farezhalim/vehicle-immobilizing-device/testing/software/Testing_Development/IMG_20190217_155356.jpg

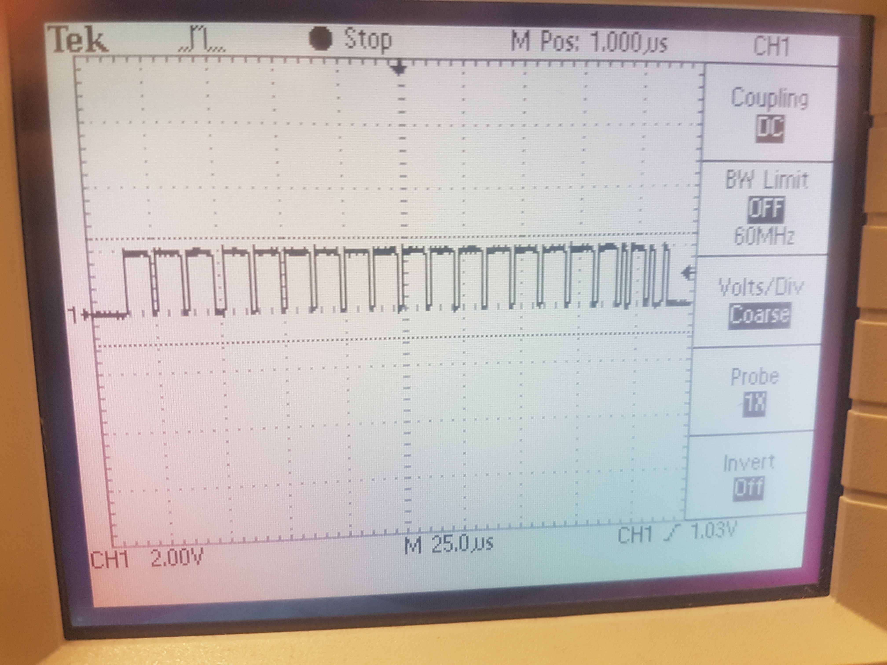
testing/software/Testing_Development/IMG_20190217_155356.jpg
