farezhalim/vehicle-immobilizing-device/hardware/mechanical/dongle_form-factor.png

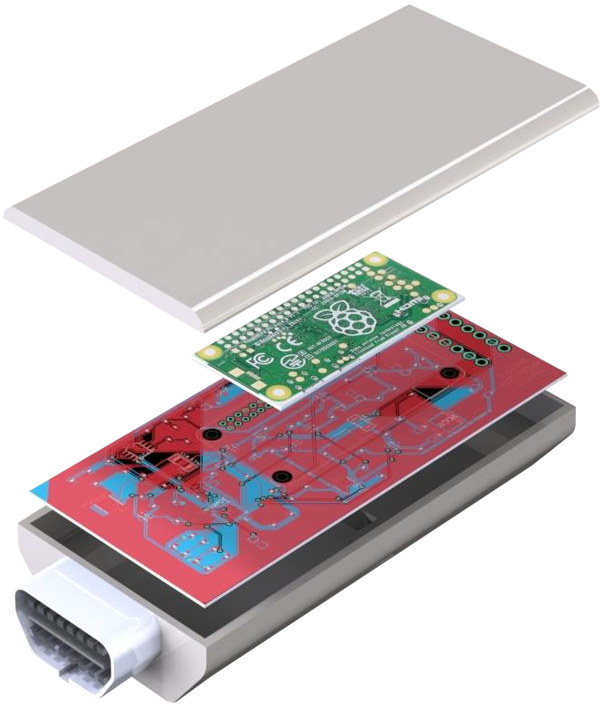
hardware/mechanical/dongle_form-factor.png
