farezhalim/vehicle-immobilizing-device/README.md

# Vehicle Immobilizing Device
*ECE Capstone 2018-2019 Group 7*

The vehicle immobilization device monitors a vehicle's speed and acceleration through a combination of OBD-II queries and a digital accelerometer, and upon detection of a collision, the device immobilizes the vehicle by injecting CAN packets to ECUs in the vehicle. To disable the immobilization, an override is sent through Bluetooth using an Android app to the device to halt CAN message injection.

There are four main sections:
1. App (For Smartphone app for authority, disabling action)
2. Hardware (All Electrical hardware schematics, pcb's, etc. Include Mechanical Design as well, solidworks files, and concept designs.)
2. Software (Resides on main processcor, Raspberry Pi Zero W)
2. Testing  (Verification using ECU Simulator)

For more info, please view the presentation slides and report document.
