farezhalim/vehicle-immobilizing-device/hardware/readme.md

# Hardware design

The folders here contain hardware and conceptual designs pertaining to the project.
1. `future` contains the EAGLE schematic and board files for the design of the final product
2. `manufacturer` contains reference material used in the design (i.e. other OBD-II interpreter board)
3. `mechanical` contains the Solidworks files associated with product casing 
4. `prototype-491` contains EAGLE schematic and board files for the proof-of-concept built during ECE 491 Capstone
5. `lbr` contains all the necessary EAGLE libraries
