farezhalim/vehicle-immobilizing-device/hardware/mechanical/locking.jpg

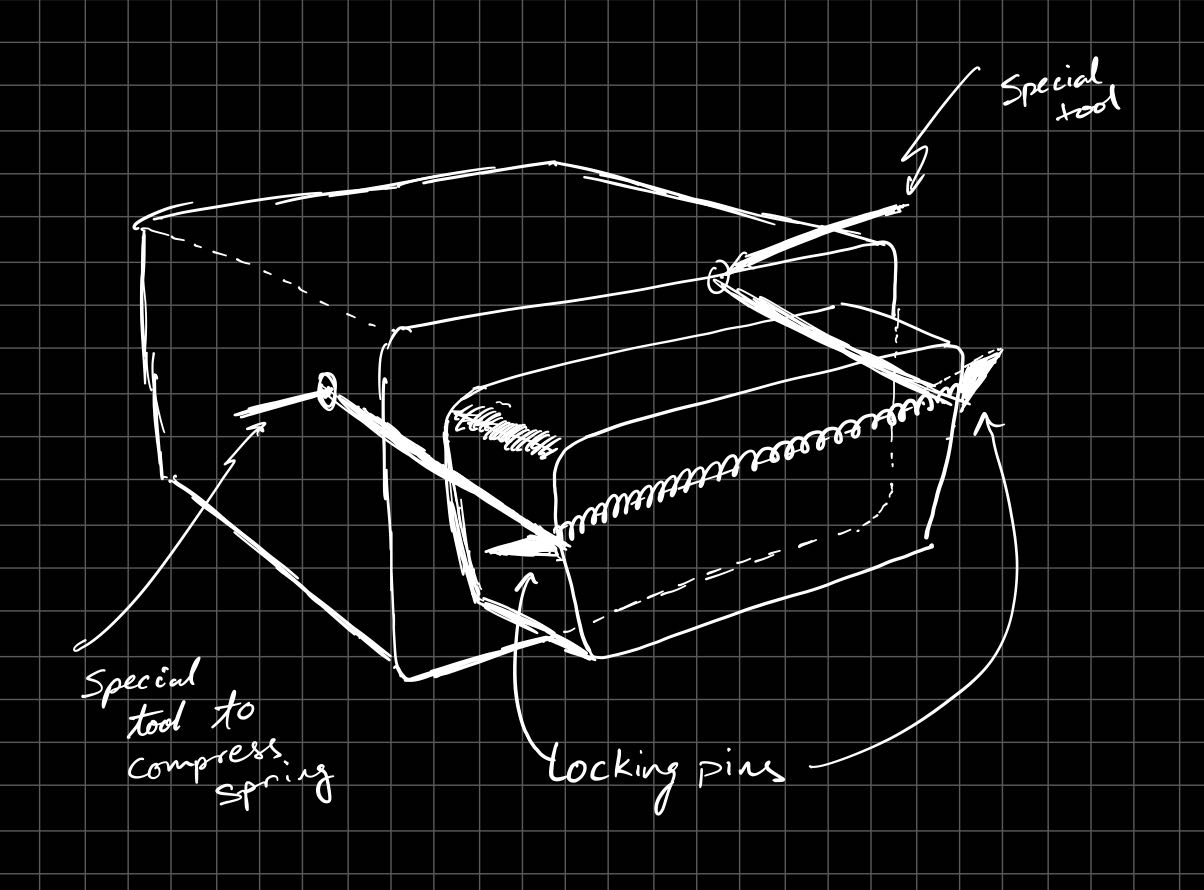
hardware/mechanical/locking.jpg
