farezhalim/vehicle-immobilizing-device/hardware/future/partslist.xlsx

Complete bill of materials
 | Value | Description |  | Qty. | Unit $ | Total $
Capacitors |  |  |  |  |  | $0.39
 | 1uF | Capacitor |  | 5 | $0.0058 | $0.03
 | 2.2uF | Capacitor |  | 1 | $0.0200 | $0.02
 | 27pF | Capacitor |  | 2 | $0.0090 | $0.02
 | 4.7uF | Capacitor |  | 1 | $0.0320 | $0.03
 | 470pF | Capacitor |  | 1 | $0.0127 | $0.01
 | 560pF | Capacitor |  | 2 | $0.0065 | $0.01
 | 10uF | Capacitor |  | 4 | $0.0490 | $0.20
 | 0.1uF | Capacitor |  | 5 | $0.0049 | $0.02
 | 10uF | Capacitor |  | 1 | $0.0490 | $0.05
Diodes |  |  |  |  |  | $1.29
 | BAS16 | Diode |  | 3 | $0.20 | $0.60
 | MBRA140 | Diode |  | 1 | $0.69 | $0.69
STN1110 - OBD II to UART Interpreter, PDIP Package |  |  |  |  |  | $7.65
 | SCANTOOL | STN1110 - OBD II to UART Interpreter, QFN-28-S |  | 1 | $7.65 | $7.65
Quad Differential Comparators |  |  |  |  |  | $1.16
 | LM339PWR | Quad Differential Comparators |  | 2 | $0.58 | $1.16
CAN Driver |  |  |  |  |  | $1.86
 | MCP2551 | CAN Driver |  | 1 | $1.86 | $1.86
Header |  |  |  |  | $2.00
 | DNP | Header |  | 1
 |  | Header |  | 1
LEDs |  |  |  |  |  | $4.38
 | RED | LED |  | 3 | $0.32 | $0.96
 | YELLOW | LED |  | 2 | $0.39 | $0.78
 | GREEN | LED |  | 3 | $0.88 | $2.64
Transistors NPN |  |  |  |  |  | $0.66
 | MMBT2222 | Transistor NPN |  | 3 | $0.22 | $0.66
Resistors |  |  |  |  |  | $2.68
 | 100 | Resistor |  | 2 | $0.033 | $0.07
 | 240 | Resistor |  | 1 | $0.033 | $0.03
 | 330 | Resistor |  | 4 | $0.072 | $0.29
 | 374 | Resistor |  | 1 | $0.007 | $0.01
 | 866 | Resistor |  | 1 | $0.072 | $0.07
 | 1.2k | Resistor |  | 1 | $0.072 | $0.07
 | 1.5k | Resistor |  | 2 | $0.072 | $0.14
 | 10k | Resistor |  | 20 | $0.033 | $0.66
 | 1k | Resistor |  | 4 | $0.034 | $0.13
 | 4.7k | Resistor |  | 3 | $0.072 | $0.22
 | 62K | Resistor |  | 1 | $0.072 | $0.07
 | 510 0.5W | Resistor |  | 2 | $0.460 | $0.92
Voltage Regulators |  |  |  |  |  | $2.48
 |  | Voltage Regulator |  | 1 | $0.83 | $0.83
 | 3.3V | Voltage Regulator |  | 1 | $0.73 | $0.73
 | 5V Reg. | Voltage Regulator |  | 1 | $0.92 | $0.92
ADXL345 - Digital 3-Axis Accelerometer (I2C/SPI) |  |  |  |  |  | $12.32
 |  | ADXL345 - Digital 3-Axis Accelerometer (I2C/SPI) |  | 1 | $12.32 | $12.32
OBD Connector |  |  |  |  |  | $1.11
 | Male OBD2 |  | https://elmwoodelectronics.ca/products/9911?variant=28164458371 | 1 | $7.99 | $7.99
Crystals |  |  |  |  |  | $1.32
 | 16MHz | Crystals |  | 1 | $1.32 | $1.32
MOSFET |  |  |  |  |  | $2.73
 | BSS138 | MOSFET |  | 4 | $0.45 | $1.80
 | ZXMP6A13FTA | MOSFET |  | 1 | $0.93 | $0.93
Raspberry Pi Zero |  |  |  |  |  | $35.03
 | RPI-ZERO | Raspberry Pi Zero W |  | 1 | $35.03 | $35.03
 |  |  |  |  | Grand total | $75.07
