farezhalim/vehicle-immobilizing-device/hardware/manufacturer/OBDII-UART/README.md

OBD-II UART
===========

<table class="table table-hover table-striped table-bordered">
  <tr align="center">
   <td><a href="https://cdn.sparkfun.com//assets/parts/3/3/1/4/09555-01a.jpg">OBD-II UART</a></td>
   <td><a href="https://cdn.sparkfun.com//assets/parts/5/7/1/5/10769-01.jpg">SparkFun Car Diagnostics Kit (RTL-10769)</a></td>
  </tr>
  <tr align="center">
    <td><a href="https://www.sparkfun.com/products/9555">OBD-II UART (WIG-09555)</a></td>
    <td><a href="https://www.sparkfun.com/products/10769">SparkFun Car Diagnostics Kit (RTL-10769)</a></td>
  </tr>
</table>

A board that provides a serial interface using the ELM327 command set with a vehicle's OBD-II bus, and supports all major OBD-II standards. 

Repository Contents
-------------------
* **/Firmware** - Example Arduino sketch
* **/Hardware** - All Eagle design files (.brd, .sch)
* **/Software** - Information about desktop program to use with this board. 

Documentation
--------------
* **[Hookup Guide](https://learn.sparkfun.com/tutorials/obd-ii-uart-hookup-guide)** - Basic hookup guide for the OBD-II UART.

Product Versions
----------------
* [WIG-09555](https://www.sparkfun.com/products/9555) - OBD-II UART board
* [RTL-10769](https://www.sparkfun.com/products/10769) - Car Diagnostics Kit Retail, with OBD-II UART and OBD to DB9 cable.

License Information
-------------------
The hardware is released under [Creative Commons Share-alike 3.0](http://creativecommons.org/licenses/by-sa/3.0/).  
All other code is open source so please feel free to do anything you want with it; you buy me a beer if you use this and we meet someday ([Beerware license](http://en.wikipedia.org/wiki/Beerware)).
