farezhalim/vehicle-immobilizing-device/hardware/manufacturer/Adafruit-ADXL345/Adafruit_ADXL345_PCB-master/readme.txt

This is the PCB for the Adafruit 5V ready ADXL345 Digital
Triple-Axis Acceleromter (I2C or SPI)

Format is EagleCAD schematic and board layout

For more details, check out the product page at

-----> https://www.adafruit.com/products/1231

Adafruit invests time and resources providing this open source design, 
please support Adafruit and open-source hardware by purchasing 
products from Adafruit!

Designed by Adafruit Industries.  
Creative Commons Attribution, Share-Alike license, check license.txt for more information
All text above must be included in any redistribution
