farezhalim/vehicle-immobilizing-device/testing/readme.md

# Testing the proof of concept

This electronic control unit (ECU) simulator  eliminates  the  need  to  procure  a  real vehicle, and mitigates risks associated with testing in the real world.

The Arduino was programmed to simulate an ECU by performing the following functions:
1. Respond to standard OBD-II parameter queries. In our case, the simulator returned a randomly generated vehicle speed
2. Indicate normal vehicle operation through a green LED
3. Perform an action (turn on a red LED) when receiving specific CAN packets to demonstrate vehicle immobilization

This code is located in `testing/software/Signal_Read_and_Write` in the .ino file.

After flashing this code on to any Arduino Uno, connect said Arduino to the CAN controller/transceiver circuitry described in `testing/hardware`. 
Connect the CAN HI/LO from the CAN Transceiver to the CAN HI/LO of the proof of concept device to establish communication between the two modules.
The Arduino was customized to accept certain packets (mimicking CAN packet injection) to cause a GPIO pin to go high, as a result powering on an LED to indicated immobilization.

In addition to vehicle speed, the Arduino can also be queried for other OBD-II parameters such as:
*  RPM
*  Coolant temperature
*  Intake air temperature (IAT)
*  Mass (air) flow (MAF)
*  Ambient air temperature

For more information about OBD-II parameters:

[http://en.wikipedia.org/wiki/OBD-II_PIDs](http://en.wikipedia.org/wiki/OBD-II_PIDs)
