farezhalim/vehicle-immobilizing-device/testing/software/Testing_Development/CAN Waveform Interpretation.pptx

0b11

Bit stuff 1

five 0’s and bit stuff 1 repeats

0

00000

101

0111

0000 with a bit stuff 1

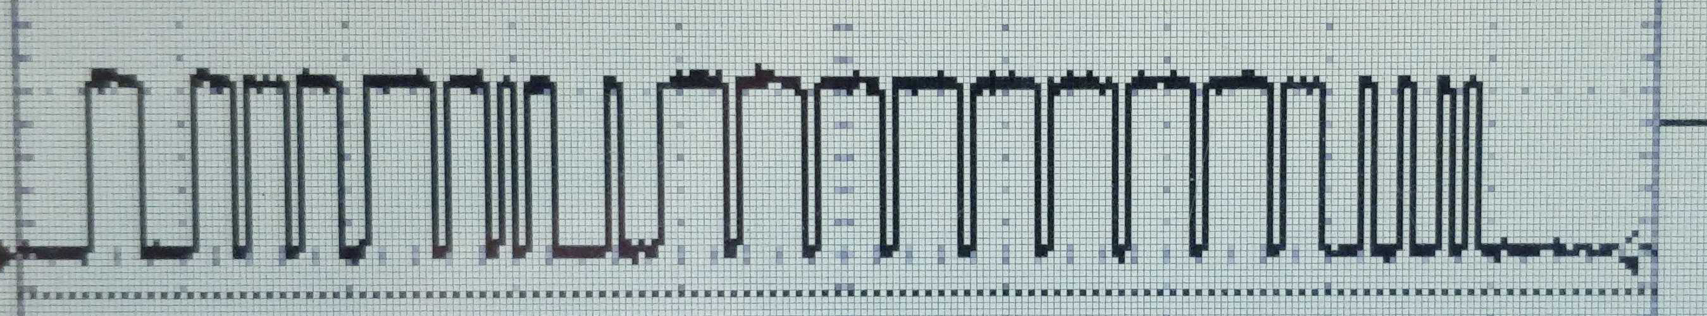
[picture p25: figure]

000

001111

0000 with a bit stuff 1

This is where the message seems to stop
