farezhalim/vehicle-immobilizing-device/testing/accelerometer/data/back_alley_drive.csv

t | x | y | z
0.04 | 1.69 | -0.04 | 8.75
0.07 | 1.65 | -0.04 | 8.63
0.11 | 1.49 | -0.04 | 8.67
0.14 | 1.61 | -0.12 | 9.02
0.18 | 1.77 | -0.08 | 8.98
0.21 | 1.65 | -0.12 | 9.18
0.25 | 1.8 | 0 | 8.63
0.29 | 1.65 | -0.04 | 8.39
0.32 | 1.49 | 0 | 8.63
0.36 | 1.65 | -0.04 | 8.87
0.39 | 1.69 | -0.04 | 8.51
0.43 | 1.69 | -0.04 | 9.34
0.46 | 1.77 | 0.04 | 9.26
0.50 | 1.65 | 0 | 8.79
0.54 | 1.53 | 0.08 | 8.94
0.57 | 1.61 | 0.04 | 8.55
0.61 | 1.61 | 0 | 8
0.64 | 1.77 | 0 | 8.98
0.68 | 1.88 | 0 | 8.9
0.71 | 1.8 | -0.04 | 8.79
0.75 | 1.8 | 0 | 9.3
0.79 | 1.88 | 0 | 8.83
0.82 | 1.57 | -0.04 | 8.47
0.86 | 1.73 | -0.08 | 8.63
0.89 | 1.84 | -0.24 | 8.47
0.93 | 1.73 | -0.16 | 9.02
0.96 | 1.8 | 0 | 8.83
1.00 | 1.65 | -0.24 | 8.83
1.04 | 1.61 | 0 | 9.02
1.07 | 1.73 | -0.08 | 9.45
1.11 | 1.49 | -0.31 | 8.39
1.14 | 1.65 | -0.47 | 8.63
1.18 | 2 | -0.31 | 8.67
1.21 | 1.92 | -0.27 | 8.32
1.25 | 1.73 | -0.16 | 9.18
1.29 | 1.88 | 0.04 | 8.98
1.32 | 1.69 | 0 | 8.59
1.36 | 1.61 | -0.08 | 8.75
1.39 | 1.92 | -0.12 | 8.67
1.43 | 1.8 | -0.2 | 8.55
1.46 | 1.77 | -0.16 | 8.87
1.50 | 1.69 | -0.04 | 8.71
1.54 | 1.53 | -0.04 | 8.67
1.57 | 1.61 | -0.04 | 8.67
1.61 | 1.8 | 0 | 8.39
1.64 | 1.8 | 0 | 8.79
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
