farezhalim/vehicle-immobilizing-device/testing/accelerometer/data/drive_2.csv

t | x | y | z
0.04 | 1.45 | -0.63 | 7.65
0.07 | 1.41 | -0.67 | 7.77
0.11 | 1.37 | -0.59 | 8.87
0.14 | 1.53 | -0.08 | 8.79
0.18 | 1.37 | -0.04 | 8.04
0.21 | 1.41 | -0.08 | 9.02
0.25 | 1.53 | -0.08 | 8.63
0.29 | 1.49 | -0.08 | 8.63
0.32 | 1.57 | 0 | 8.59
0.36 | 1.84 | 0.12 | 9.02
0.39 | 1.77 | 0.43 | 8.98
0.43 | 1.69 | 0.35 | 10.04
0.46 | 1.8 | 0.39 | 9.3
0.50 | 1.92 | 0.43 | 8.79
0.54 | 1.57 | 0.27 | 8.98
0.57 | 1.49 | 0.31 | 8.98
0.61 | 1.53 | 0.04 | 8.67
0.64 | 1.53 | 0.08 | 8.75
0.68 | 1.8 | 0.16 | 8.87
0.71 | 1.8 | 0.31 | 8.43
0.75 | 1.33 | 0.43 | 9.3
0.79 | 1.29 | 0.2 | 9.14
0.82 | 1.29 | 0.04 | 8.04
0.86 | 1.45 | 0.08 | 8.67
0.89 | 1.57 | 0.08 | 8.79
0.93 | 1.45 | 0 | 8.39
0.96 | 1.26 | 0.08 | 8.59
1.00 | 1.33 | 0.31 | 8.9
1.04 | 1.37 | 0.43 | 9.1
1.07 | 1.26 | 0.39 | 8.71
1.11 | 1.33 | 0.35 | 8.87
1.14 | 1.26 | 0.39 | 9.22
1.18 | 1.29 | 0.16 | 8.63
1.21 | 1.26 | 0.24 | 8.83
1.25 | 1.49 | 0.31 | 9.45
1.29 | 1.57 | 0.47 | 9.26
1.32 | 1.37 | 0.31 | 9.34
1.36 | 1.41 | 0.27 | 9.06
1.39 | 1.49 | 0.16 | 9.14
1.43 | 1.45 | 0.12 | 8.04
1.46 | 1.22 | 0 | 8
1.50 | 1.29 | 0.04 | 9.18
1.54 | 1.57 | -0.04 | 9.49
1.57 | 1.41 | -0.04 | 8.43
1.61 | 1.41 | 0 | 8.47
1.64 | 1.29 | 0.12 | 8.32
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
