farezhalim/vehicle-immobilizing-device/testing/accelerometer/data/drive_3.csv

t | x | y | z
0.04 | 1.49 | 0.12 | 8.24
0.07 | 1.49 | 0.35 | 8
0.11 | 1.18 | 0.39 | 8.67
0.14 | 1.14 | 0.16 | 9.14
0.18 | 1.37 | 0.24 | 9.41
0.21 | 1.57 | 0.27 | 9.14
0.25 | 1.57 | 0.63 | 8.94
0.29 | 1.49 | 0.75 | 8.94
0.32 | 1.49 | 0.63 | 8.87
0.36 | 1.49 | 0.35 | 9.02
0.39 | 1.61 | 0.2 | 8.94
0.43 | 1.61 | 0.24 | 9.1
0.46 | 1.53 | 0.2 | 8.9
0.50 | 1.53 | 0.08 | 8.39
0.54 | 1.49 | 0 | 8.24
0.57 | 1.37 | 0.04 | 8.32
0.61 | 1.33 | 0 | 8.94
0.64 | 1.49 | -0.08 | 9.14
0.68 | 1.49 | 0.12 | 8.32
0.71 | 1.45 | 0.31 | 8.63
0.75 | 1.37 | 0.47 | 8.83
0.79 | 1.1 | 0.75 | 9.45
0.82 | 1.45 | 0.31 | 9.65
0.86 | 1.53 | 0.67 | 9.02
0.89 | 1.49 | 0.82 | 8.67
0.93 | 1.37 | 0.98 | 9.3
0.96 | 1.06 | 0.82 | 8.98
1.00 | 1.26 | 0.24 | 9.22
1.04 | 1.06 | 0.43 | 8.43
1.07 | 0.82 | -0.27 | 8.43
1.11 | 0.43 | -0.24 | 8.51
1.14 | 0.47 | -0.35 | 8.43
1.18 | 0.47 | -0.24 | 8.36
1.21 | 0.43 | -0.12 | 8.2
1.25 | 0.59 | -0.04 | 8.12
1.29 | 0.43 | 0.04 | 8.75
1.32 | 0.51 | 0 | 8.67
1.36 | 0.51 | 0.12 | 8.28
1.39 | 0.47 | 0.12 | 8.2
1.43 | 0.35 | 0.08 | 8.71
1.46 | 0.35 | 0.2 | 9.1
1.50 | 0.51 | 0 | 9.34
1.54 | 0.51 | -0.12 | 9.45
1.57 | 0.63 | -0.04 | 8.36
1.61 | 0.47 | -0.31 | 8.94
1.64 | 0.12 | -0.24 | 10.24
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
