farezhalim/vehicle-immobilizing-device/testing/accelerometer/data/drive_4.csv

t | x | y | z
0.04 | 0.78 | -0.51 | 8.55
0.07 | 1.02 | -0.27 | 8.51
0.11 | 0.82 | -0.27 | 9.1
0.14 | 0.78 | -0.24 | 9.73
0.18 | 1.1 | -0.39 | 8.55
0.21 | 0.78 | -0.43 | 9.06
0.25 | 1.14 | -0.63 | 7.92
0.29 | 0.71 | -0.24 | 8.98
0.32 | 0.78 | -0.2 | 9.34
0.36 | 1.02 | -0.31 | 9.38
0.39 | 0.67 | -0.35 | 8.79
0.43 | 0.98 | -0.08 | 8.87
0.46 | 0.67 | -0.35 | 8.94
0.50 | 0.86 | -0.12 | 8.39
0.54 | 0.75 | -0.16 | 9.53
0.57 | 0.9 | -0.31 | 8.87
0.61 | 1.02 | -0.04 | 8.9
0.64 | 0.55 | -0.31 | 8.36
0.68 | 1.18 | -0.55 | 9.02
0.71 | 0.59 | -0.24 | 8.47
0.75 | 0.86 | -0.16 | 9.06
0.79 | 0.78 | -0.04 | 8.94
0.82 | 1.06 | -0.04 | 8.67
0.86 | 0.63 | -0.27 | 8.55
0.89 | 0.63 | -0.51 | 8.83
0.93 | 0.47 | -0.43 | 9.26
0.96 | 0.94 | -0.27 | 8.47
1.00 | 0.82 | -0.16 | 9.06
1.04 | 1.18 | -0.12 | 9.02
1.07 | 1.18 | -0.08 | 8.36
1.11 | 0.55 | -0.08 | 9.3
1.14 | 1.06 | -0.35 | 8.32
1.18 | 0.63 | -0.24 | 9.1
1.21 | 1.22 | 0 | 8.47
1.25 | 0.86 | -0.08 | 9.26
1.29 | 0.98 | -0.04 | 8.32
1.32 | 0.98 | 0 | 9.1
1.36 | 0.98 | -0.08 | 8.9
1.39 | 0.98 | 0.04 | 8.83
1.43 | 1.06 | -0.35 | 8.36
1.46 | 1.1 | -0.16 | 8.71
1.50 | 1.1 | -0.27 | 8.83
1.54 | 0.9 | -0.27 | 7.57
1.57 | 1.37 | -0.47 | 8.9
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
