farezhalim/vehicle-immobilizing-device/testing/accelerometer/data/hardbrake_1.csv

t | x | y | z
0.04 | 1.1 | -0.63 | 8.71
0.07 | 1.1 | -0.63 | 8.83
0.11 | 1.1 | -0.55 | 8.79
0.14 | 1.02 | -0.59 | 8.79
0.18 | 1.06 | -0.63 | 8.83
0.21 | 1.06 | -0.67 | 8.79
0.25 | 1.18 | -0.67 | 8.87
0.29 | 1.06 | -0.63 | 8.83
0.32 | 1.29 | -0.55 | 8.79
0.36 | 1.14 | -0.63 | 8.67
0.39 | 1.14 | -0.55 | 8.75
0.43 | 1.1 | -0.82 | 8.87
0.46 | 1.18 | -0.59 | 8.83
0.50 | 1.14 | -0.67 | 8.79
0.54 | 1.02 | -0.63 | 8.83
0.57 | 1.84 | -0.82 | 8.67
0.61 | 0.98 | -0.63 | 8.75
0.64 | 0.86 | -0.71 | 8.83
0.68 | 1.18 | -0.78 | 8.87
0.71 | 1.1 | -0.59 | 8.9
0.75 | 1.22 | -0.51 | 8.79
0.79 | 1.18 | -0.63 | 8.79
0.82 | 0.98 | -0.63 | 8.67
0.86 | 1.18 | -0.63 | 8.67
0.89 | 1.22 | -0.78 | 8.83
0.93 | 1.22 | -0.67 | 8.71
0.96 | 1.02 | -0.63 | 8.79
1.00 | 1.1 | -0.55 | 8.98
1.04 | 1.06 | -0.82 | 8.79
1.07 | 0.98 | -0.71 | 8.9
1.11 | 1.26 | -0.35 | 8.83
1.14 | 0.9 | -0.67 | 8.47
1.18 | 0.9 | -0.51 | 8.79
1.21 | 0.94 | -0.51 | 8.75
1.25 | 1.06 | -0.67 | 8.83
1.29 | 1.1 | -0.67 | 8.83
1.32 | 1.14 | -0.67 | 8.71
1.36 | 0.98 | -0.63 | 8.83
1.39 | 1.02 | -0.71 | 8.71
1.43 | 1.18 | -0.51 | 8.87
1.46 | 0.98 | -0.51 | 8.75
1.50 | 0.78 | -0.78 | 8.9
1.54 | 1.33 | -0.86 | 8.83
1.57 | 0.86 | -0.82 | 8.83
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
