farezhalim/vehicle-immobilizing-device/testing/accelerometer/data/hardbrake_2.csv

t | x | y | z
0.04 | 0.94 | -0.98 | 8.9
0.07 | 0.98 | -1.06 | 8.83
0.102857143 | 0.86 | -1.26 | 8.28
0.13 | 0.63 | -0.98 | 8.43
0.165714286 | 0.86 | -0.59 | 9.14
0.20 | 0.94 | -0.51 | 9.49
0.228571429 | 0.86 | -0.35 | 9.18
0.26 | 0.94 | -0.39 | 8.83
0.291428571 | 1.14 | -0.43 | 8.51
0.32 | 1.49 | -0.47 | 8.55
0.354285714 | 1.57 | -0.47 | 8.79
0.39 | 1.53 | -0.43 | 8.79
0.417142857 | 1.26 | -0.35 | 8.94
0.45 | 1.33 | -0.43 | 8.9
0.48 | 1.45 | -0.43 | 8.87
0.51 | 1.37 | -0.63 | 8.39
0.542857143 | 1.41 | -0.78 | 8.63
0.57 | 1.49 | -0.98 | 8.59
0.605714286 | 1.49 | -1.02 | 8.51
0.64 | 1.33 | -1.02 | 8.83
0.668571429 | 1.29 | -0.75 | 8.98
0.70 | 1.45 | -0.51 | 9.02
0.731428571 | 1.45 | -0.16 | 9.02
0.76 | 1.69 | 0 | 8.83
0.794285714 | 1.84 | -0.04 | 9.14
0.83 | 1.96 | -0.16 | 8.94
0.857142857 | 1.84 | -0.47 | 8.83
0.89 | 1.84 | -0.55 | 8.67
0.92 | 1.88 | -0.59 | 8.47
0.95 | 2 | -0.71 | 8.51
0.982857143 | 1.92 | -0.63 | 8.87
1.01 | 2.2 | -0.71 | 9.14
1.045714286 | 2.35 | -0.86 | 8.94
1.08 | 2.51 | -1.1 | 8.67
1.108571429 | 2.63 | -1.29 | 8.43
1.14 | 2.86 | -1.45 | 8.63
1.171428571 | 3.06 | -1.29 | 8.67
1.20 | 2.98 | -1.02 | 8.51
1.234285714 | 2.75 | -0.86 | 8.67
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
