farezhalim/vehicle-immobilizing-device/testing/accelerometer/data/acc_hard_brake_1g.png

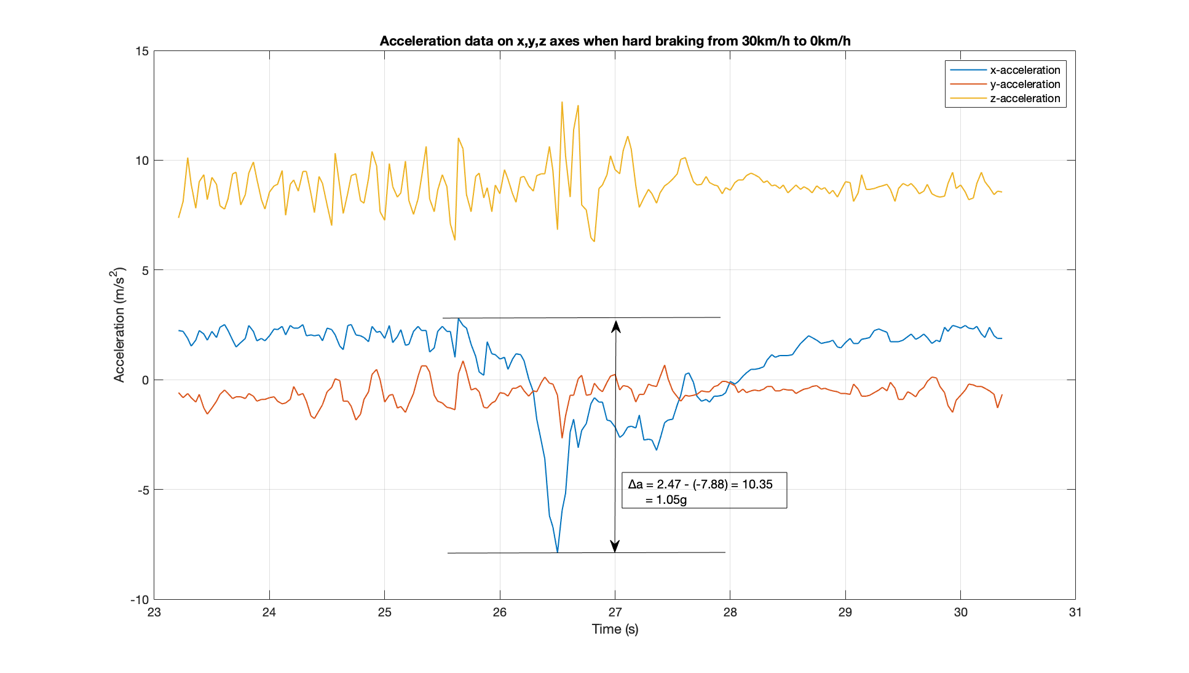
testing/accelerometer/data/acc_hard_brake_1g.png
