farezhalim/vehicle-immobilizing-device/testing/accelerometer/data/acc_pothole.png

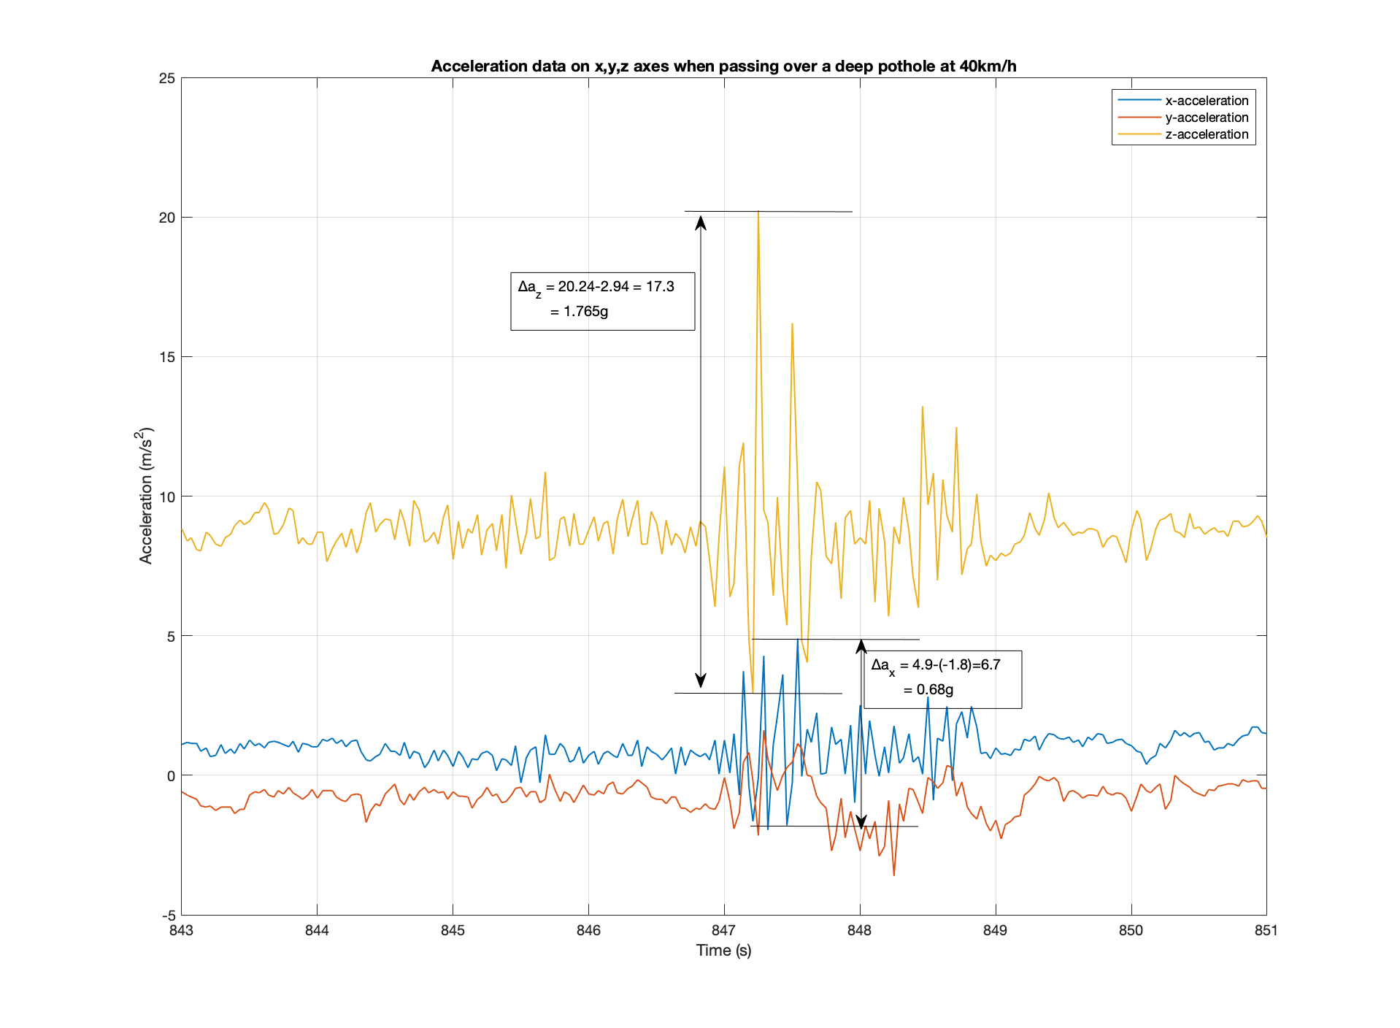
testing/accelerometer/data/acc_pothole.png
