farezhalim/vehicle-immobilizing-device/testing/accelerometer/data/acc_speedbump.png

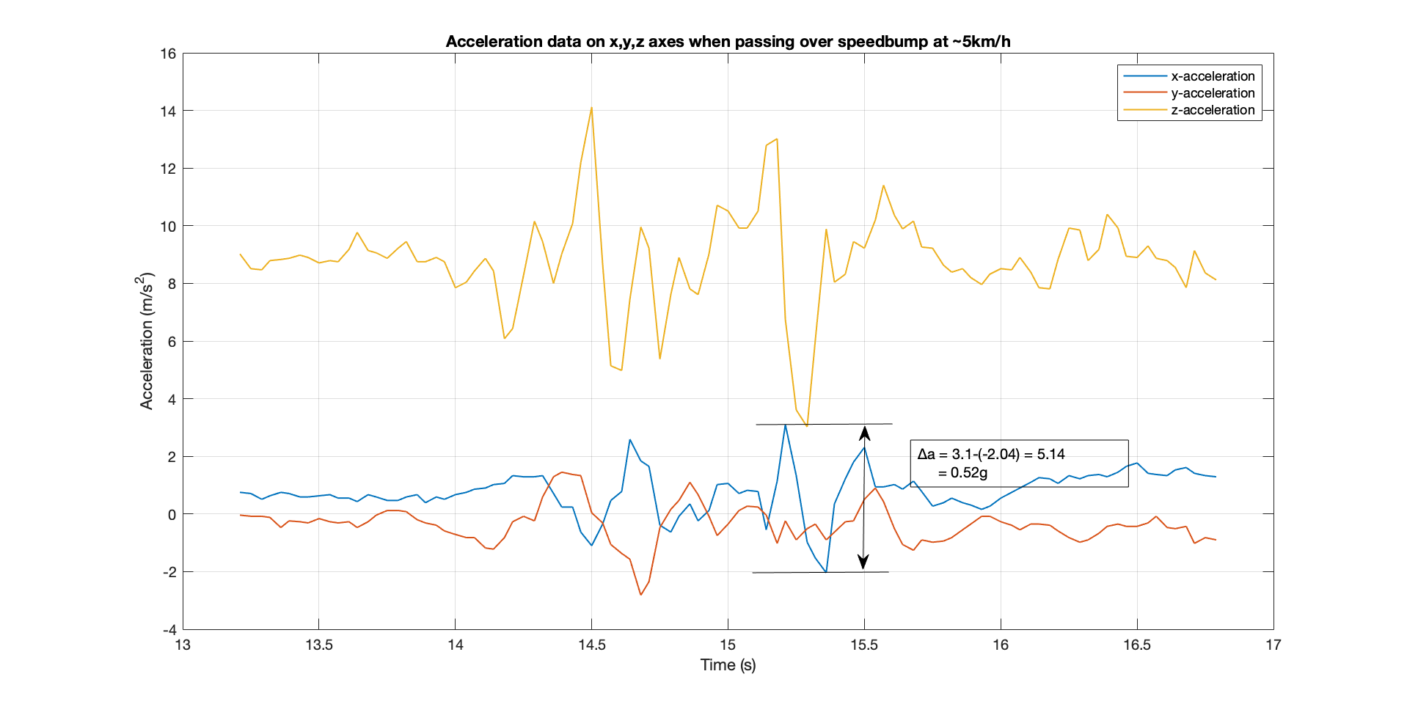
testing/accelerometer/data/acc_speedbump.png
