farezhalim/vehicle-immobilizing-device/testing/software/Testing_Development/0xC0 29 EE 00 00 00 00 00.jpg

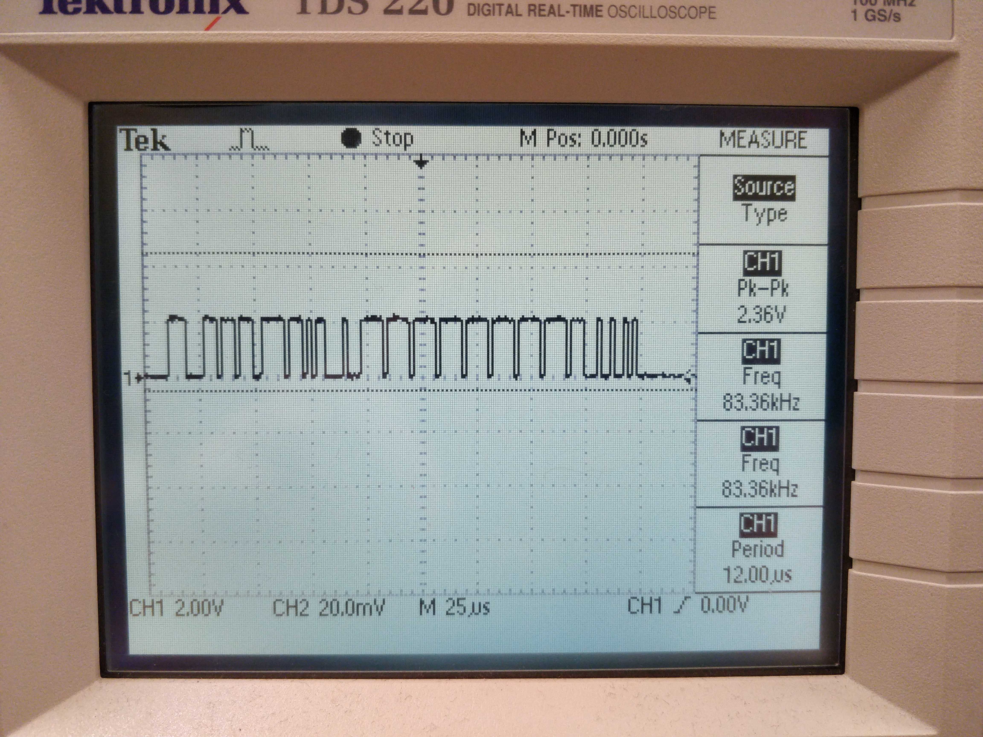
testing/software/Testing_Development/0xC0 29 EE 00 00 00 00 00.jpg
