farezhalim/vehicle-immobilizing-device/testing/software/Testing_Development/IMG_20190217_155527.jpg

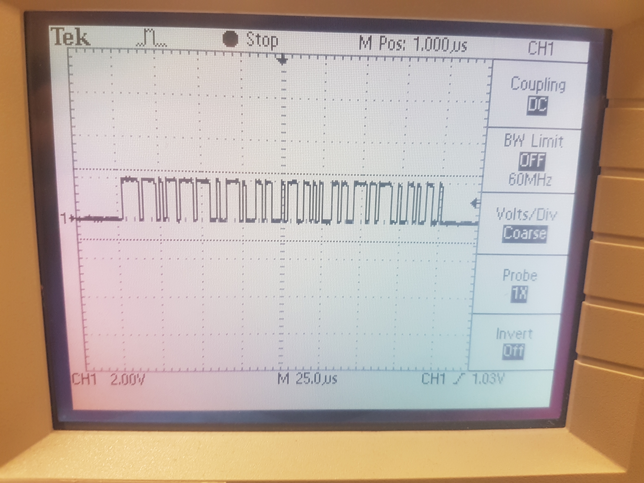
testing/software/Testing_Development/IMG_20190217_155527.jpg
