farezhalim/vehicle-immobilizing-device/hardware/manufacturer/OBDII-UART/Hardware/OBD-II-UART.brd

## EAGLE design hardware/manufacturer/OBDII-UART/Hardware/OBD-II-UART.brd (2019-03-20)

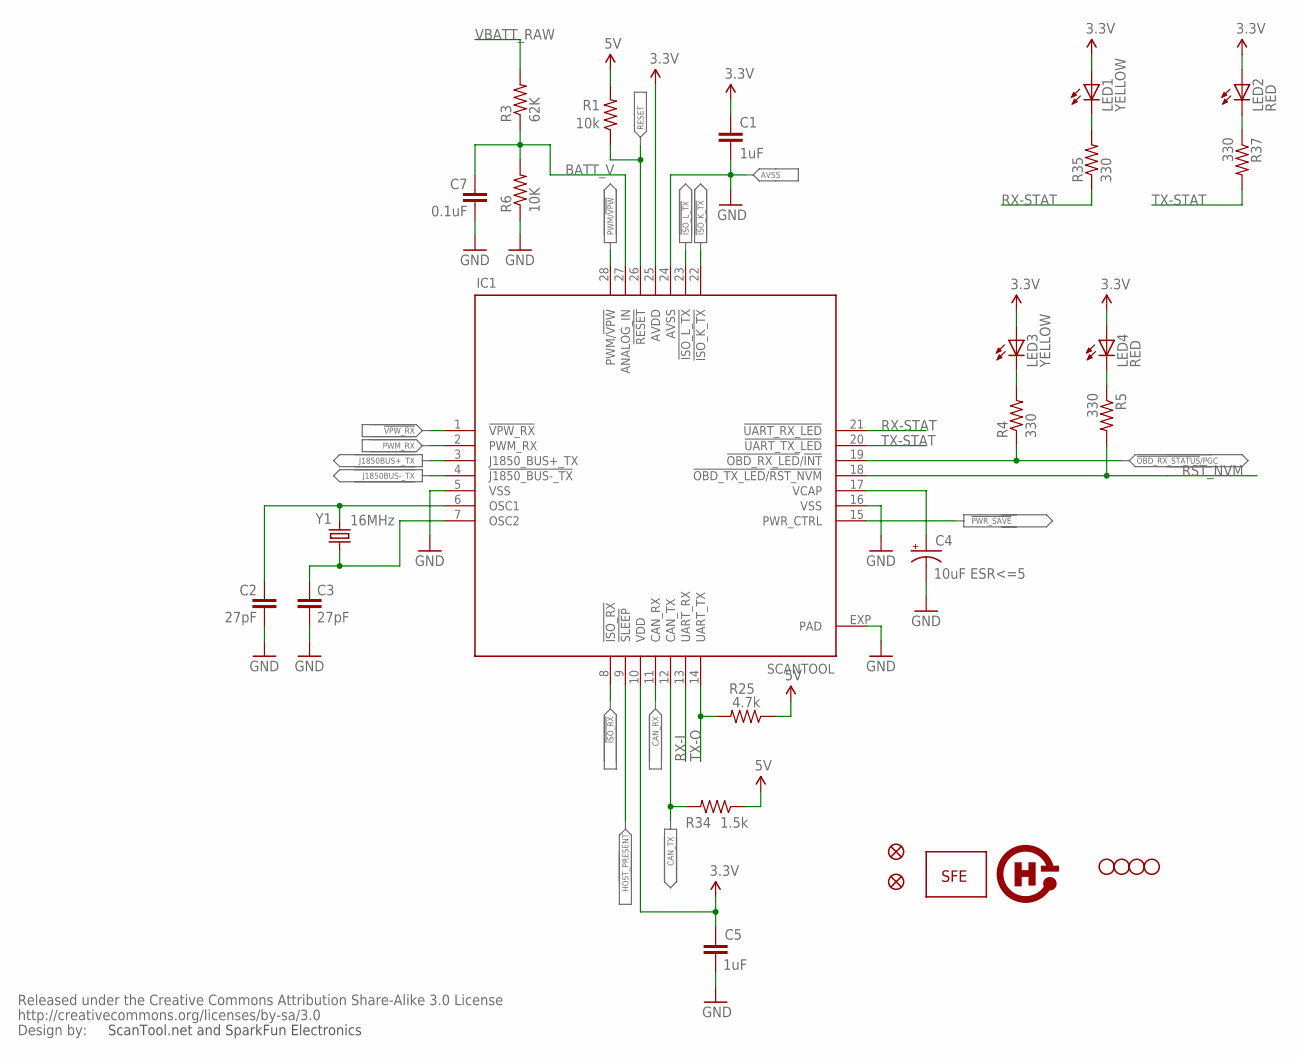
[picture p31: schematic OBD-II-UART.sch, sheet 1]

Parts:
C1, C5: 1uF; 0402-CAP
C2, C3: 27pF; 0402-CAP
C4: 10uF ESR<=5; EIA3216
C7: 0.1uF; 0402-CAP
IC1: SCANTOOL; _STN_SCANTOOL_QFN-28-S
JP2, JP10: FIDUCIAL1X2; FIDUCIAL-1X2
JP3: LOGO-SFENEW; SFE-NEW-WEBLOGO
JP4, JP5, JP6, JP7: STAND-OFF
LED1, LED3: YELLOW; LED-0603
LED2, LED4: RED; LED-0603
R1: 10k; 0402-RES
R3: 62K; 0402-RES
R4, R5, R35, R37: 330; 0402-RES
R6: 10K; 0402-RES
R25: 4.7k; 0402-RES
R34: 1.5k; 0402-RES
U$1: CREATIVE_COMMONS
U$14: OSHW-LOGO
Y1: 16MHz; CRYSTAL-SMD-5X3

Connections:
3.3V: C1.1, C5.1, IC1.10 (VDD), IC1.25 (AVDD), LED1.A, LED2.A, LED3.A, LED4.A; also elsewhere on the board
5V: R1.2, R25.1, R34.1; also elsewhere on the board
!ISO_K_TX: IC1.22 (!ISO_K_TX); also elsewhere on the board
!ISO_L_TX: IC1.23 (!ISO_L_TX); also elsewhere on the board
!ISO_RX: IC1.8 (!ISO_RX); also elsewhere on the board
!OBD_RX_STATUS!/PGC: IC1.19 (!OBD_RX_LED!/!INT), R4.1
!PWR_SAVE: IC1.15 (PWR_CTRL)
!VPW_RX: IC1.1 (!VPW_RX); also elsewhere on the board
BATT_V: C7.1, IC1.27 (ANALOG_IN), R3.1, R6.2
CAN_RX: IC1.11 (CAN_RX); also elsewhere on the board
CAN_TX: IC1.12 (CAN_TX), R34.2; also elsewhere on the board
GND: C1.2, C2.2, C3.2, C4.C (-), C5.2, C7.2, IC1.5 (VSS), IC1.16 (VSS), IC1.24 (AVSS), IC1.EXP (PAD), R6.1; also elsewhere on the board
HOST_PRESENT: IC1.9 (!SLEEP)
J1850BUS+_TX: IC1.3 (J1850_BUS+_TX); also elsewhere on the board
J1850BUS-_TX: IC1.4 (!J1850_BUS-_TX); also elsewhere on the board
unnamed: C4.A (+), IC1.17 (VCAP)
unnamed: LED3.C, R4.2
unnamed: LED4.C, R5.1
unnamed: LED1.C, R35.2
unnamed: LED2.C, R37.1
OSC1: C2.1, IC1.6 (OSC1), Y1.3 (2)
OSC2: C3.1, IC1.7 (OSC2), Y1.1
PWM/!VPW: IC1.28 (PWM/!VPW); also elsewhere on the board
PWM_RX: IC1.2 (PWM_RX); also elsewhere on the board
RESET: IC1.26 (!RESET), R1.1
RST_NVM: IC1.18 (!OBD_TX_LED!/!RST_NVM), R5.2; also elsewhere on the board
RX-I: IC1.13 (UART_RX); also elsewhere on the board
RX-STAT: IC1.21 (!UART_RX_LED), R35.1
TX-O: IC1.14 (UART_TX), R25.2; also elsewhere on the board
TX-STAT: IC1.20 (!UART_TX_LED), R37.2
VBATT_RAW: R3.2; also elsewhere on the board

Notes on the sheet:
AVSS
ScanTool.net and SparkFun Electronics

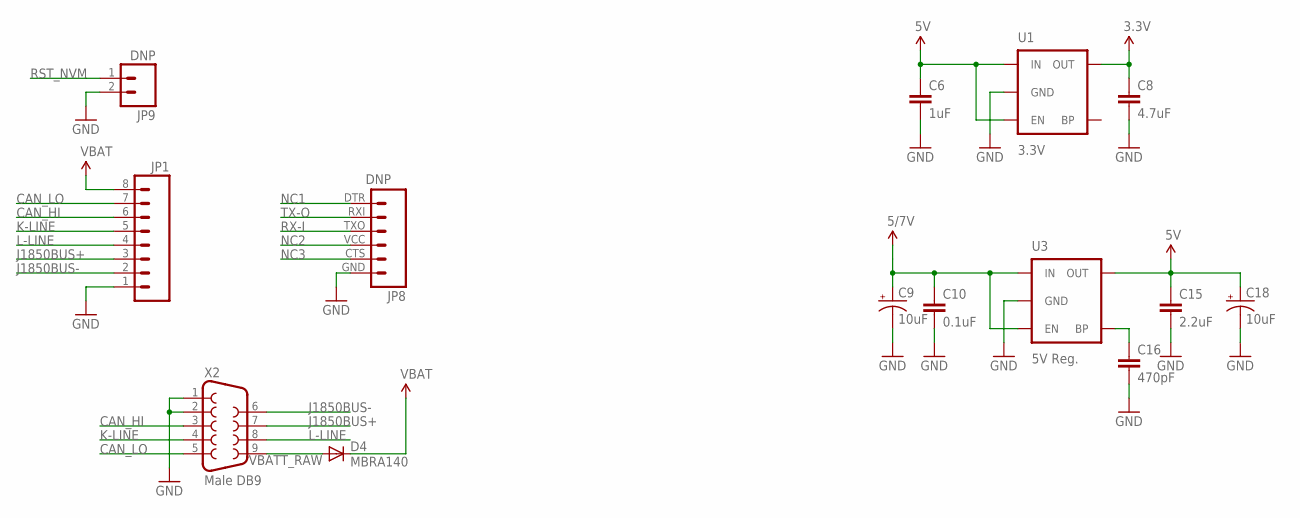
[picture p32: schematic OBD-II-UART.sch, sheet 2]

Parts:
C6: 1uF; 0402-CAP
C8: 4.7uF; 0402-CAP
C9, C18: 10uF; EIA3216
C10: 0.1uF; 0402-CAP
C15: 2.2uF; 0402-CAP
C16: 470pF; 0402-CAP
D4: MBRA140; SMA-DIODE
JP1: M08; 1X08
JP8: DNP; FTDI_BASIC
JP9: DNP; 1X02
U1: 3.3V; SOT23-5
U3: 5V Reg.; SOT23-5
X2: Male DB9; DB9_MALE

Connections:
3.3V: C8.1, U1.5 (OUT); also elsewhere on the board
5V: C6.1, C15.1, C18.A (+), U1.1 (IN), U1.3 (EN), U3.5 (OUT); also elsewhere on the board
CAN_HI: JP1.6, X2.3; also elsewhere on the board
CAN_LO: JP1.7, X2.5; also elsewhere on the board
GND: C6.2, C8.2, C9.C (-), C10.2, C15.2, C16.2, C18.C (-), JP1.1, JP8.GND (6), JP9.2, U1.2 (GND), U3.2 (GND), X2.1, X2.2; also elsewhere on the board
J1850BUS+: JP1.3, X2.7; also elsewhere on the board
J1850BUS-: JP1.2, X2.6; also elsewhere on the board
K-LINE: JP1.5, X2.4; also elsewhere on the board
L-LINE: JP1.4, X2.8; also elsewhere on the board
unnamed: C16.1, U3.4 (BP)
NC1: JP8.DTR (1)
NC2: JP8.VCC (4)
NC3: JP8.CTS (5)
RST_NVM: JP9.1; also elsewhere on the board
RX-I: JP8.TXO (3); also elsewhere on the board
TX-O: JP8.RXI (2); also elsewhere on the board
VBAT: D4.C, JP1.8; also elsewhere on the board
VBATT_RAW: D4.A, X2.9; also elsewhere on the board
VCC: C9.A (+), C10.1, U3.1 (IN), U3.3 (EN); also elsewhere on the board

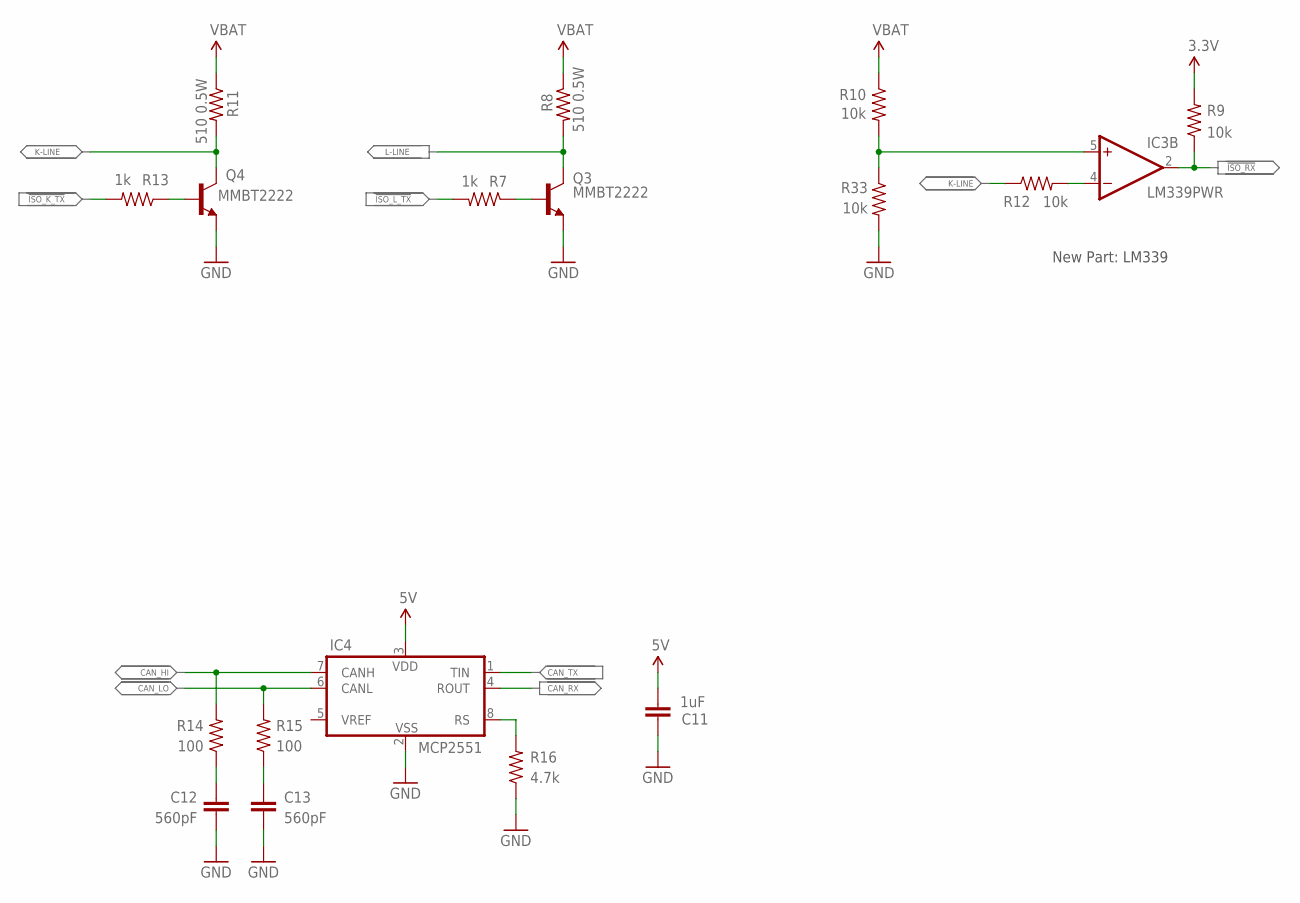
[picture p33: schematic OBD-II-UART.sch, sheet 3]

Parts:
C11: 1uF; 0402-CAP
C12, C13: 560pF; 0402-CAP
IC3: LM339PWR; TSSOP-14
IC4: MCP2551; SO-8
Q3, Q4: MMBT2222; SOT23-3
R7, R13: 1k; 0402-RES
R8, R11: 510 0.5W; 2010
R9, R10, R12, R33: 10k; 0402-RES
R14, R15: 100; 0402-RES
R16: 4.7k; 0402-RES

Connections:
3.3V: R9.2; also elsewhere on the board
5V: C11.1, IC4.3 (VDD); also elsewhere on the board
!ISO_K_TX: R13.2; also elsewhere on the board
!ISO_L_TX: R7.2; also elsewhere on the board
!ISO_RX: IC3.2 (OUT), R9.1; also elsewhere on the board
CAN_HI: IC4.7 (CANH), R14.2; also elsewhere on the board
CAN_LO: IC4.6 (CANL), R15.2; also elsewhere on the board
CAN_RX: IC4.4 (ROUT); also elsewhere on the board
CAN_TX: IC4.1 (TIN); also elsewhere on the board
GND: C11.2, C12.2, C13.2, IC4.2 (VSS), Q3.2 (E), Q4.2 (E), R16.1, R33.2; also elsewhere on the board
K-LINE: Q4.3 (C), R11.2, R12.1; also elsewhere on the board
L-LINE: Q3.3 (C), R8.2; also elsewhere on the board
unnamed: Q4.1 (B), R13.1
unnamed: Q3.1 (B), R7.1
unnamed: IC3.5 (+IN), R10.2, R33.1
unnamed: C12.1, R14.1
unnamed: IC4.8 (RS), R16.2
unnamed: IC3.4 (-IN), R12.2
unnamed: C13.1, R15.1
VBAT: R8.1, R10.1, R11.1; also elsewhere on the board

Notes on the sheet:
New Part: LM339

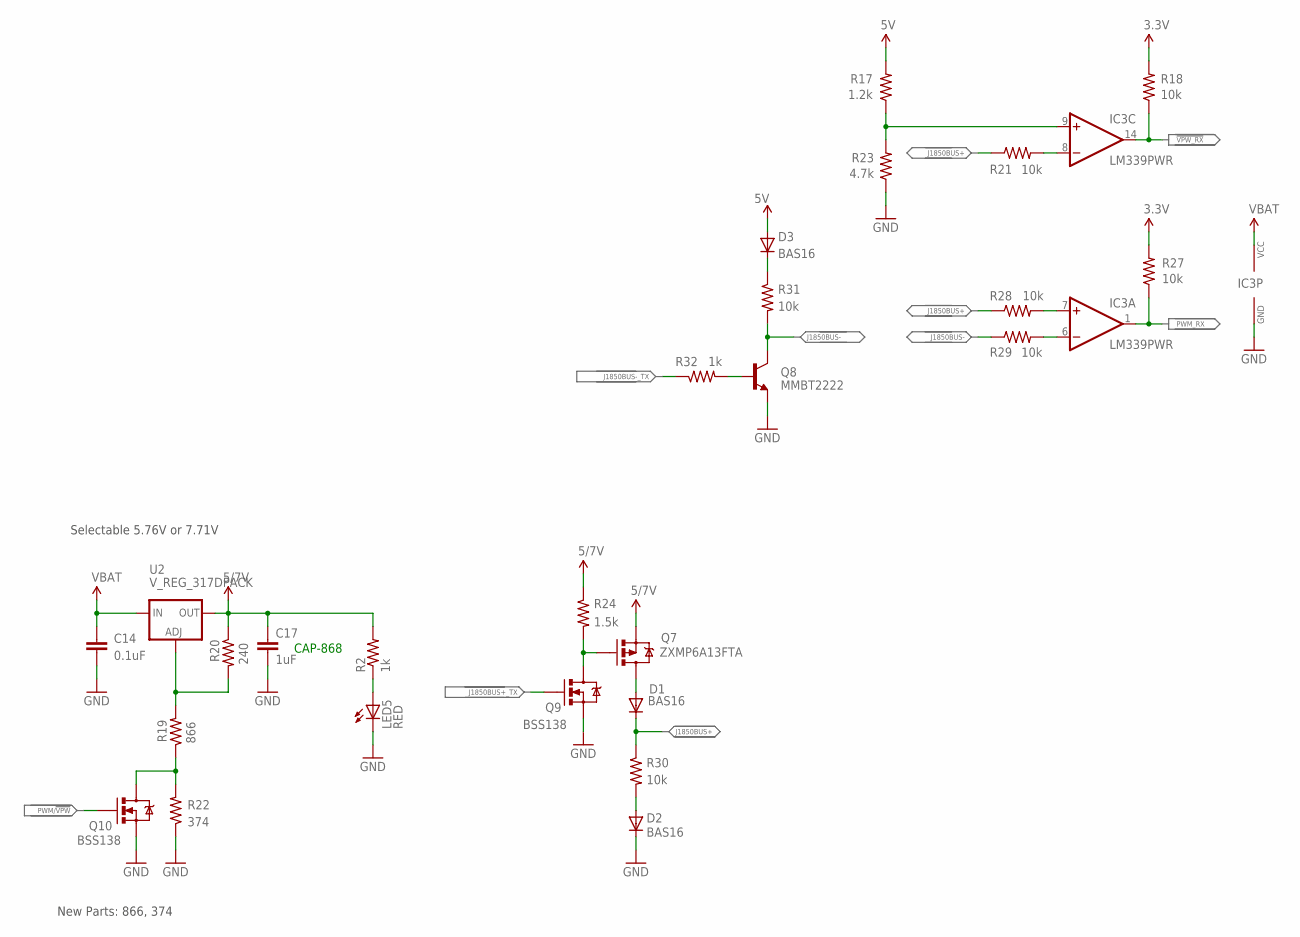
[picture p34: schematic OBD-II-UART.sch, sheet 4]

Parts:
C14: 0.1uF; 0402-CAP
C17: 1uF; 0402-CAP
D1, D2, D3: BAS16; SOD-323
IC3: LM339PWR; TSSOP-14
LED5: RED; LED-0603
Q7: ZXMP6A13FTA; SOT23
Q8: MMBT2222; SOT23-3
Q9, Q10: BSS138; SOT23-3
R2, R32: 1k; 0402-RES
R17: 1.2k; 0402-RES
R18, R21, R27, R28, R29, R30, R31: 10k; 0402-RES
R19: 866; 0402-RES
R20: 240; 0402-RES
R22: 374; 0402-RES
R23: 4.7k; 0402-RES
R24: 1.5k; 0402-RES
U2: V_REG_317DPACK; V-REG_DPACK

Connections:
3.3V: R18.2, R27.2; also elsewhere on the board
5V: D3.2 (A), R17.2; also elsewhere on the board
!VPW_RX: IC3.14 (OUT), R18.1; also elsewhere on the board
GND: C14.2, C17.2, D2.1 (C), IC3.12 (GND), LED5.C, Q8.2 (E), Q9.2 (S), Q10.2 (S), R22.1, R23.1; also elsewhere on the board
J1850BUS+: D1.1 (C), R21.1, R28.1, R30.1; also elsewhere on the board
J1850BUS+_TX: Q9.1 (G); also elsewhere on the board
J1850BUS-: Q8.3 (C), R29.1, R31.2; also elsewhere on the board
J1850BUS-_TX: R32.1; also elsewhere on the board
unnamed: IC3.7 (+IN), R28.2
unnamed: IC3.6 (-IN), R29.2
unnamed: IC3.8 (-IN), R21.2
unnamed: R19.2, R20.2, U2.1 (ADJ)
unnamed: D1.2 (A), Q7.3 (D)
unnamed: IC3.9 (+IN), R17.1, R23.2
unnamed: D3.1 (C), R31.1
unnamed: Q7.1 (G), Q9.3 (D), R24.2
unnamed: Q10.3 (D), R19.1, R22.2
unnamed: D2.2 (A), R30.2
unnamed: Q8.1 (B), R32.2
unnamed: LED5.A, R2.1
PWM/!VPW: Q10.1 (G); also elsewhere on the board
PWM_RX: IC3.1 (OUT), R27.1; also elsewhere on the board
VBAT: C14.1, IC3.3 (VCC), U2.3 (IN); also elsewhere on the board
VCC: C17.1, Q7.2 (S), R2.2, R20.1, R24.1, U2.4 (OUT); also elsewhere on the board

Notes on the sheet:
Selectable 5.76V or 7.71V
New Parts: 866, 374
CAP-868

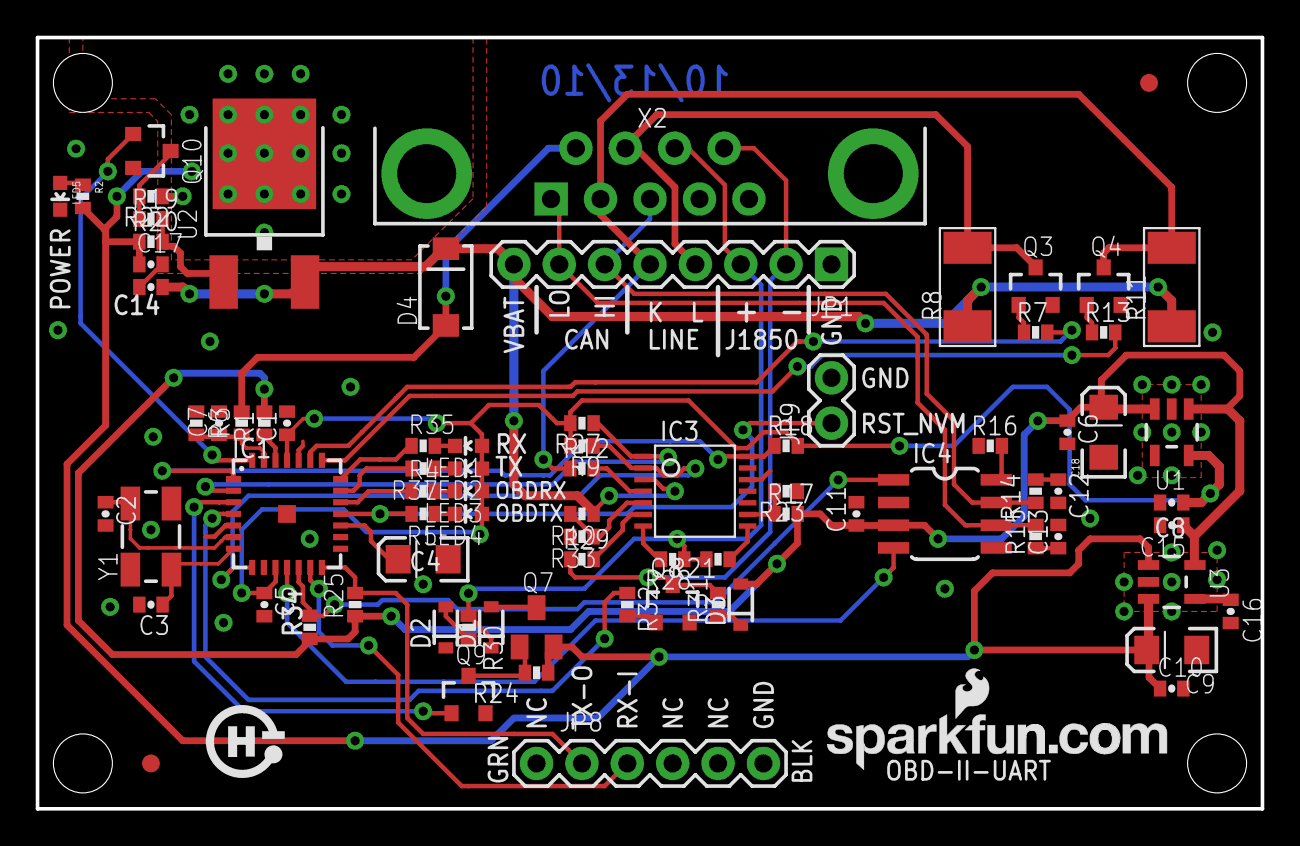
[picture p35: board OBD-II-UART.brd from above]

Board: 2 copper layers, 68.6 x 43.2 mm, 88 parts (0 on the bottom side), 57 nets.
