farezhalim/vehicle-immobilizing-device/hardware/prototype-491/schematic.brd

## EAGLE design hardware/prototype-491/schematic.brd (2019-03-20)

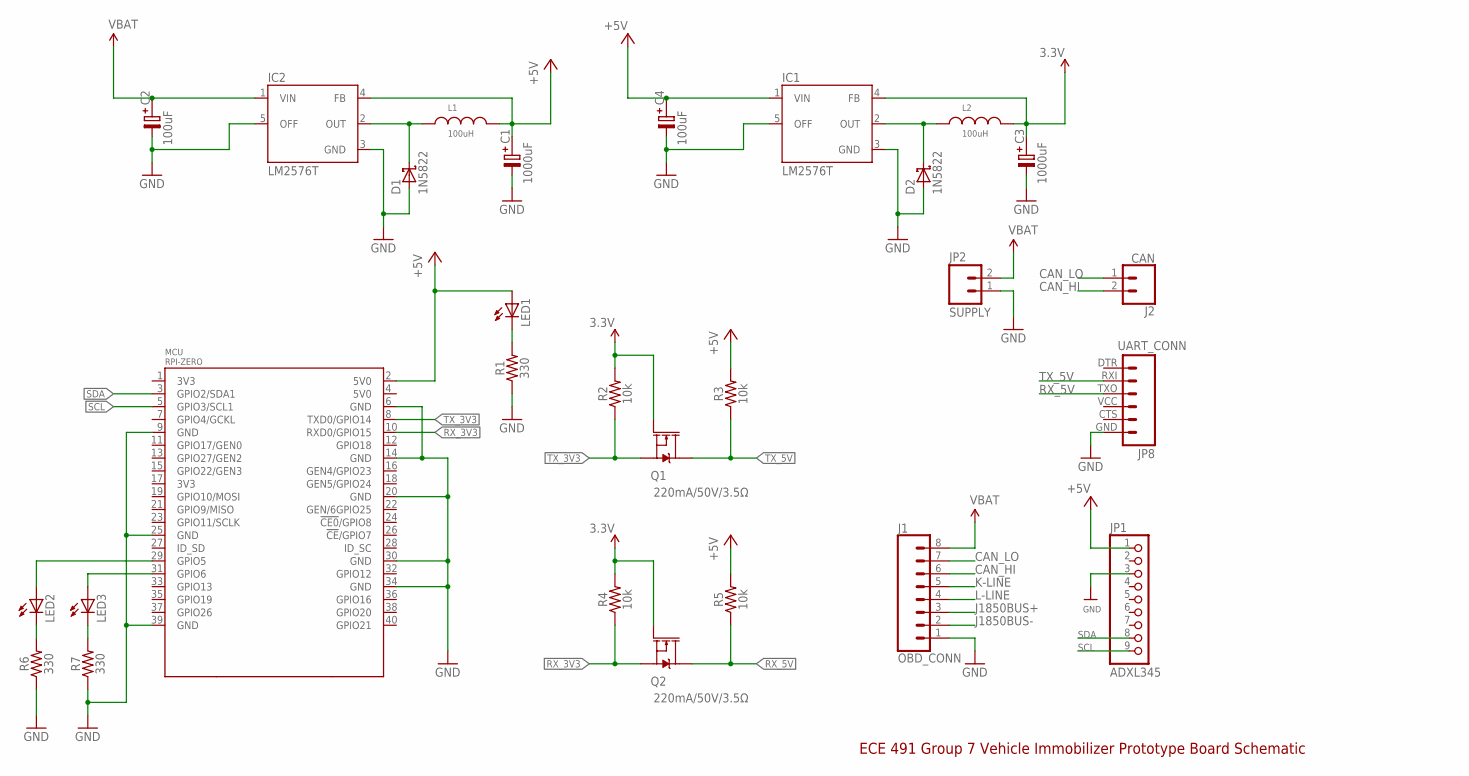
[picture p36: schematic schematic.sch]

Parts:
C1, C3: 1000uF; E3,5-8
C2, C4: 100uF; E3,5-8
D1, D2: 1N5822; DIOAD2120W130L950D530P
IC1, IC2: LM2576T; TO220-5
J1: OBD_CONN; 1X08
J2: CAN; MOLEX-1X2
JP1: ADXL345; 1X09_ROUND_70
JP2: SUPPLY; SCREWTERMINAL-3.5MM-2
JP8: UART_CONN; FTDI_BASIC
L1, L2: 100uH; WE-TI_1014
LED1, LED2, LED3: LED3MM
MCU: RPI-ZERO; RASPBERRYPI_BASTELSTUBE_V13_RASPI_BOARD_B+_FULL
Q1, Q2: 220mA/50V/3.5Ω; SOT23-3
R1, R6, R7: 330; AXIAL-0.3
R2, R3, R4, R5: 10k; AXIAL-0.3

Connections:
3.3V: C3.+, IC1.4 (FB), L2.2, Q1.1 (G), Q2.1 (G), R2.P$2 (2), R4.P$2 (2)
+5V: C1.+, C4.+, IC1.1 (VIN), IC2.4 (FB), JP1.1, L1.2, LED1.A, MCU.2 (5V0), R3.P$2 (2), R5.P$2 (2)
CAN_HI: J1.6, J2.2
CAN_LO: J1.7, J2.1
GND: C1.-, C2.-, C3.-, C4.-, D1.A, D2.A, IC1.3 (GND), IC1.5 (OFF), IC2.3 (GND), IC2.5 (OFF), J1.1, JP1.3, JP2.1, JP8.GND (6), MCU.6 (GND), MCU.9 (GND), MCU.14 (GND), MCU.20 (GND), MCU.25 (GND), MCU.30 (GND), MCU.34 (GND), MCU.39 (GND), R1.P$1 (1), R6.P$1 (1), R7.P$1 (1)
J1850BUS+: J1.3
J1850BUS-: J1.2
K-LINE: J1.5
L-LINE: J1.4
unnamed: D2.C, IC1.2 (OUT), L2.1
unnamed: D1.C, IC2.2 (OUT), L1.1
unnamed: LED2.K (C), R6.P$2 (2)
unnamed: LED3.K (C), R7.P$2 (2)
unnamed: LED1.K (C), R1.P$2 (2)
RX_3V3: MCU.10 (RXD0/GPIO15), Q2.2 (S), R4.P$1 (1)
RX_5V: JP8.TXO (3), Q2.3 (D), R5.P$1 (1)
SCL: JP1.9, MCU.5 (GPIO3/SCL1)
SDA: JP1.8, MCU.3 (GPIO2/SDA1)
STAT_LED1: LED2.A, MCU.29 (GPIO5)
STAT_LED2: LED3.A, MCU.31 (GPIO6)
TX_3V3: MCU.8 (TXD0/GPIO14), Q1.2 (S), R2.P$1 (1)
TX_5V: JP8.RXI (2), Q1.3 (D), R3.P$1 (1)
VBAT: C2.+, IC2.1 (VIN), J1.8, JP2.2

Notes on the sheet:
ECE 491 Group 7 Vehicle Immobilizer Prototype Board Schematic

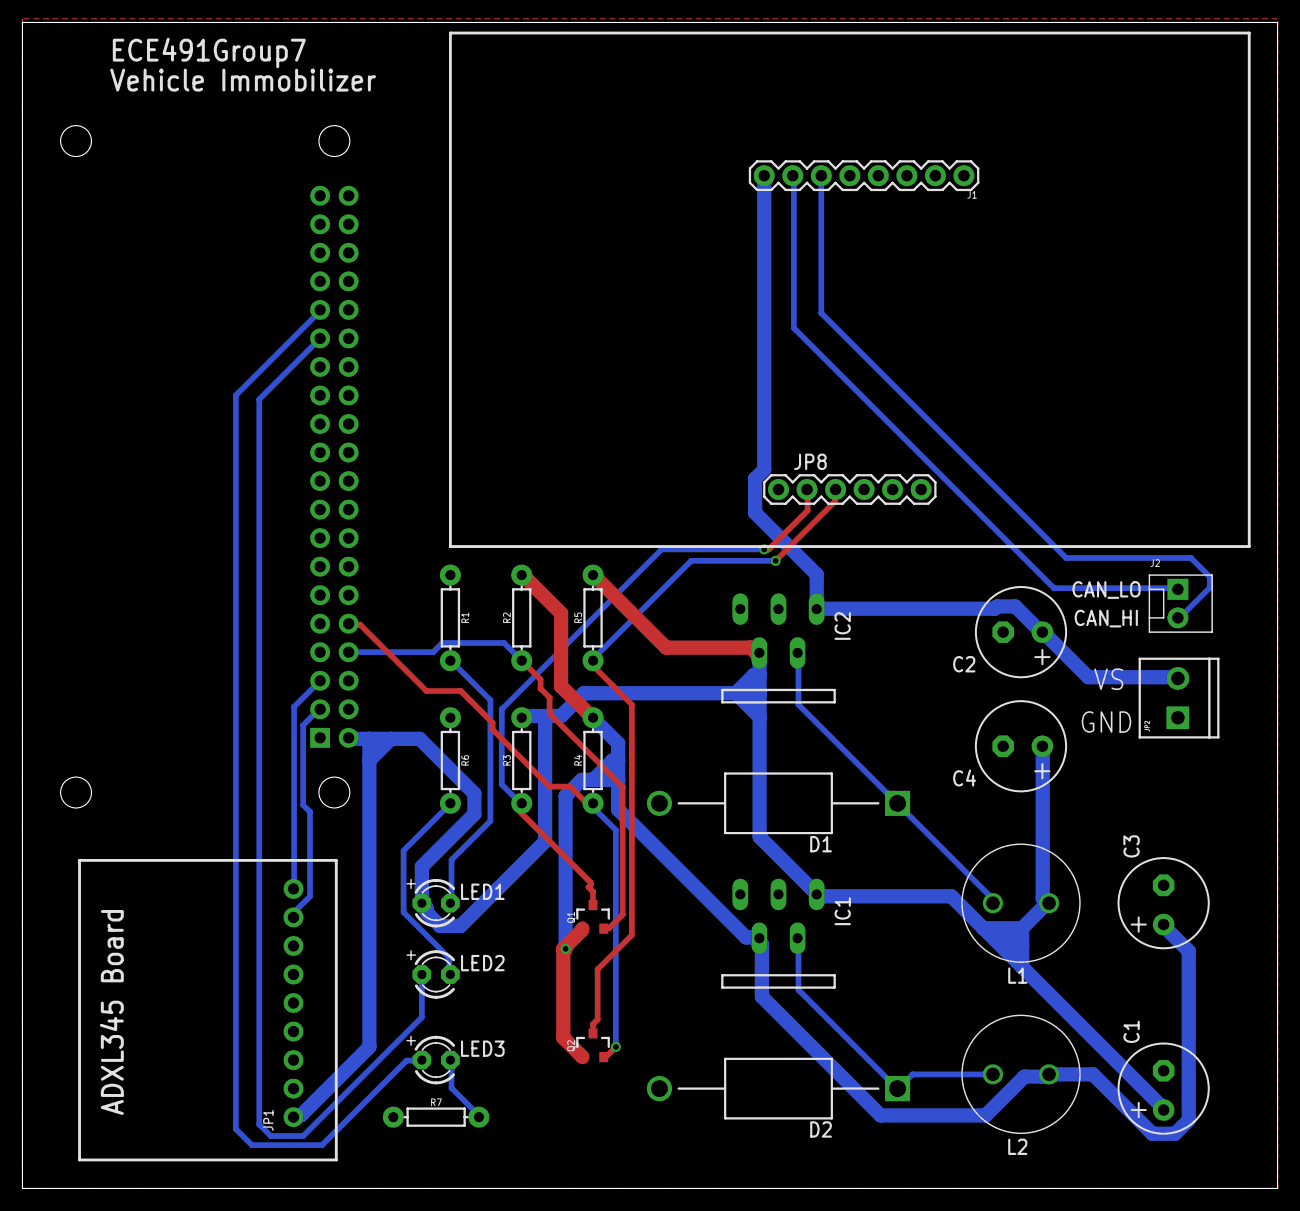
[picture p37: board schematic.brd from above]

Board: 2 copper layers, 111.7 x 103.8 mm, 28 parts (1 on the bottom side), 19 nets.
