farezhalim/vehicle-immobilizing-device/hardware/manufacturer/Adafruit-ADXL345/Adafruit_ADXL345_PCB-master/Adafruit_ADXL345.brd

## EAGLE design hardware/manufacturer/Adafruit-ADXL345/Adafruit_ADXL345_PCB-master/Adafruit_ADXL345.brd (2019-02-05)

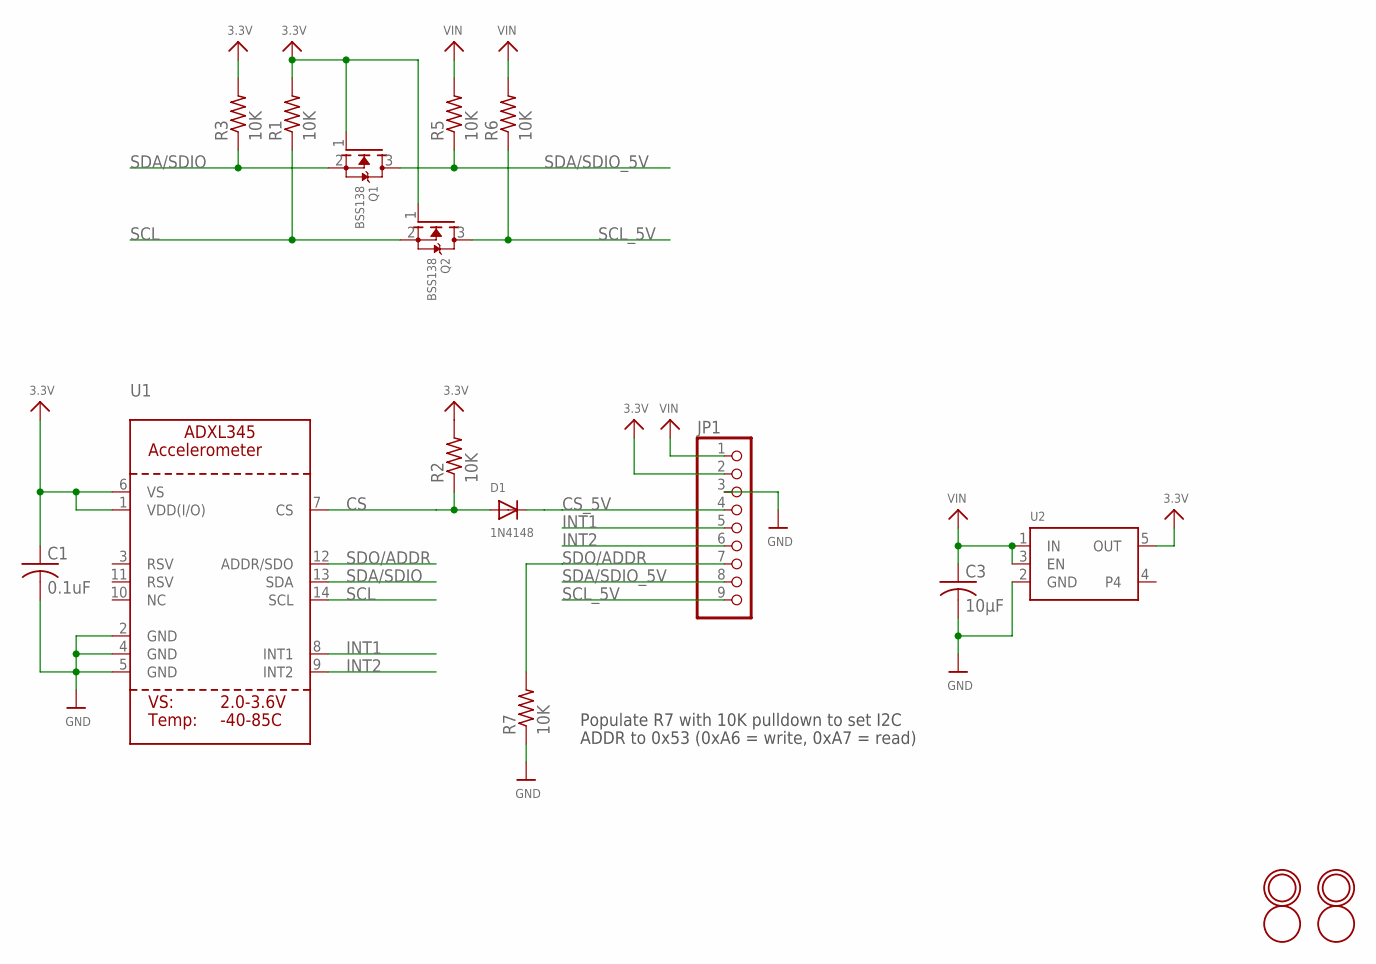
[picture p38: schematic Adafruit_ADXL345.sch]

Parts:
C1: 0.1uF; C0805
C3: 10µF; C0805
D1: 1N4148; SOD-323
JP1: HEADER-1X970MIL; 1X09_ROUND_70
Q1, Q2: BSS138; SOT23-WIDE
R1, R2, R3, R5, R6, R7: 10K; R0805
U1: ACCEL_ADXL345; LGA14
U2: VREG_SOT23-5; SOT23-5
U$1, U$3: FIDUCIAL; FIDUCIAL_1MM
U$4, U$6: MOUNTINGHOLE2.5; MOUNTINGHOLE_2.5_PLATED

Connections:
3.3V: C1.1, JP1.2, Q1.1 (G), Q2.1 (G), R1.2, R2.2, R3.2, U1.1 (VDD(I/O)), U1.6 (VS), U2.5 (OUT)
CS: D1.A, R2.1, U1.7 (CS)
CS_5V: D1.C, JP1.4
GND: C1.2, C3.2, JP1.3, R7.1, U1.2 (GND), U1.4 (GND), U1.5 (GND), U2.2 (GND)
INT1: JP1.5, U1.8 (INT1)
INT2: JP1.6, U1.9 (INT2)
SCL: Q2.2 (S), R1.1, U1.14 (SCL)
SCL_5V: JP1.9, Q2.3 (D), R6.1
SDA/SDIO: Q1.2 (S), R3.1, U1.13 (SDA)
SDA/SDIO_5V: JP1.8, Q1.3 (D), R5.1
SDO/ADDR: JP1.7, R7.2, U1.12 (ADDR/SDO)
VIN: C3.1, JP1.1, R5.2, R6.2, U2.1 (IN), U2.3 (EN)

Notes on the sheet:
Populate R7 with 10K pulldown to set I2C
ADDR to 0x53 (0xA6 = write, 0xA7 = read)

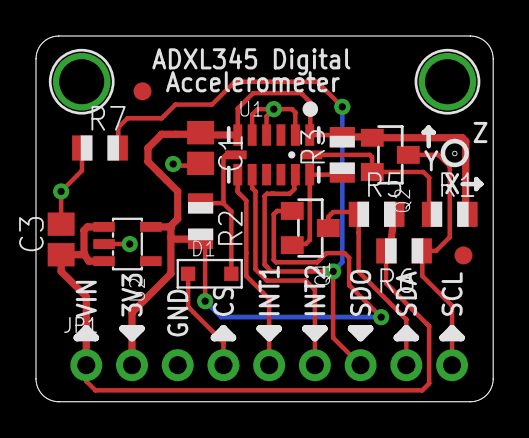
[picture p39: board Adafruit_ADXL345.brd from above]

Board: 2 copper layers, 25.4 x 20.3 mm, 19 parts (1 on the bottom side), 12 nets.

Other parts of the board:
U$7: ADAFRUIT_TEXT_20MM
