farezhalim/vehicle-immobilizing-device/hardware/manufacturer/OBDII-UART/Production/OBD-II-UART_Panel_v13.brd

## EAGLE design hardware/manufacturer/OBDII-UART/Production/OBD-II-UART_Panel_v13.brd (2019-02-05)

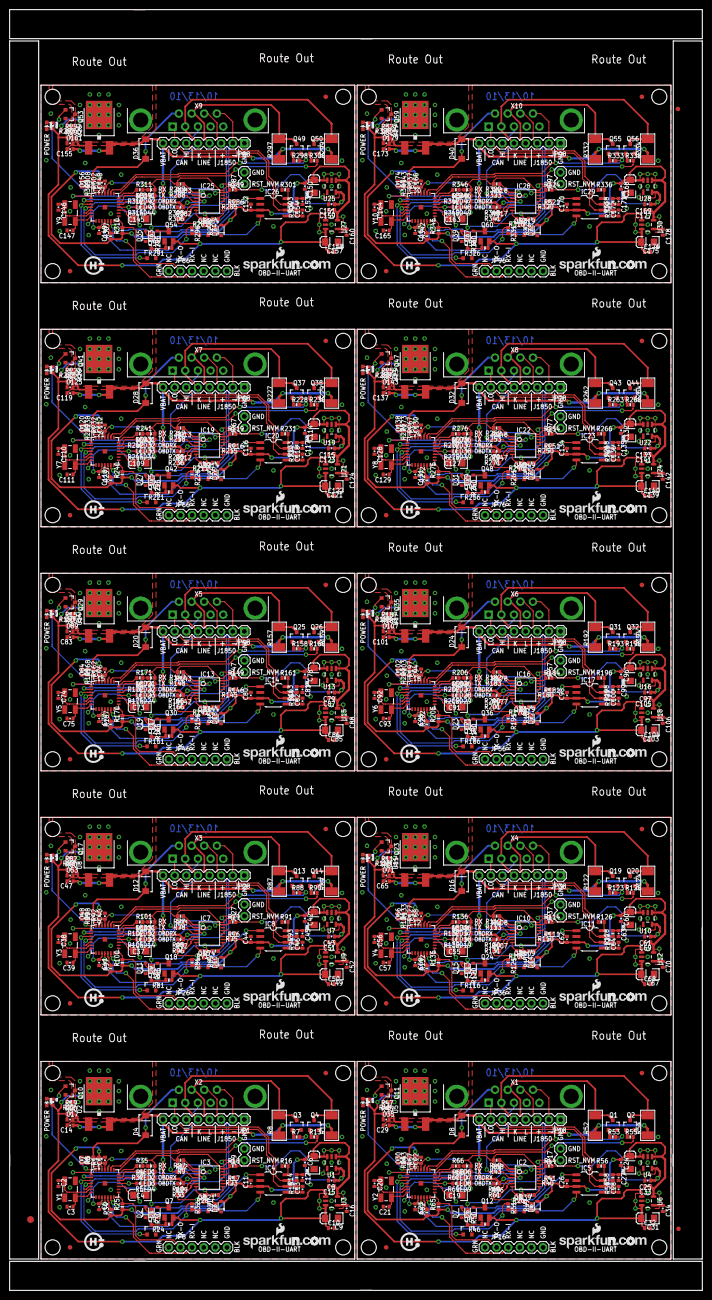
[picture p40: board OBD-II-UART_Panel_v13.brd from above]

Board: 2 copper layers, 151.4 x 279.9 mm, 873 parts (0 on the bottom side), 570 nets.

Parts:
C1, C5, C6, C11, C17, C22, C23, C24, C26, C35, C40, C41, C42, C44, C53, C58, C59, C60, C62, C71, C76, C77, C78, C80, C89, C94, C95, C96, C98, C107, C112, C113, C114, C116, C125, C130, C131, C132, C134, C143, C148, C149, C150, C152, C161, C166, C167, C168, C170, C179: 1uF; 0402-CAP
C2, C3, C20, C21, C38, C39, C56, C57, C74, C75, C92, C93, C110, C111, C128, C129, C146, C147, C164, C165: 27pF; 0402-CAP
C4, C19, C37, C55, C73, C91, C109, C127, C145, C163: 10uF ESR<=5; EIA3216
C7, C10, C14, C29, C30, C32, C47, C48, C50, C65, C66, C68, C83, C84, C86, C101, C102, C104, C119, C120, C122, C137, C138, C140, C155, C156, C158, C173, C174, C176: 0.1uF; 0402-CAP
C8, C25, C43, C61, C79, C97, C115, C133, C151, C169: 4.7uF; 0402-CAP
C9, C18, C31, C36, C49, C54, C67, C72, C85, C90, C103, C108, C121, C126, C139, C144, C157, C162, C175, C180: 10uF; EIA3216
C12, C13, C27, C28, C45, C46, C63, C64, C81, C82, C99, C100, C117, C118, C135, C136, C153, C154, C171, C172: 560pF; 0402-CAP
C15, C33, C51, C69, C87, C105, C123, C141, C159, C177: 2.2uF; 0402-CAP
C16, C34, C52, C70, C88, C106, C124, C142, C160, C178: 470pF; 0402-CAP
D1, D2, D3, D5, D6, D7, D9, D10, D11, D13, D14, D15, D17, D18, D19, D21, D22, D23, D25, D26, D27, D29, D30, D31, D33, D34, D35, D37, D38, D39: BAS16; SOD-323
D4, D8, D12, D16, D20, D24, D28, D32, D36, D40: MBRA140; SMA-DIODE
E$1: FIDUCIAL-1.5X3
E$5, E$8: FIDUCIAL-1X2
IC1, IC6, IC9, IC12, IC15, IC18, IC21, IC24, IC27, IC30: SCANTOOL; _STN_SCANTOOL_QFN-28-S
IC2, IC3, IC7, IC10, IC13, IC16, IC19, IC22, IC25, IC28: LM339PWR; TSSOP-14
IC4, IC5, IC8, IC11, IC14, IC17, IC20, IC23, IC26, IC29: MCP2551; SO-8
JP1, JP18, JP28, JP38, JP48, JP58, JP68, JP78, JP88, JP98: 1X08
JP2, JP10, JP19, JP20, JP29, JP30, JP39, JP40, JP49, JP50, JP59, JP60, JP69, JP70, JP79, JP80, JP89, JP90, JP99, JP100: FIDUCIAL1X2; FIDUCIAL-1X2
JP3, JP11, JP21, JP31, JP41, JP51, JP61, JP71, JP81, JP91: LOGO-SFENEW; SFE-NEW-WEBLOGO
JP4, JP5, JP6, JP7, JP12, JP13, JP14, JP15, JP22, JP23, JP24, JP25, JP32, JP33, JP34, JP35, JP42, JP43, JP44, JP45, JP52, JP53, JP54, JP55, JP62, JP63, JP64, JP65, JP72, JP73, JP74, JP75, JP82, JP83, JP84, JP85, JP92, JP93, JP94, JP95: STAND-OFF
JP8, JP16, JP26, JP36, JP46, JP56, JP66, JP76, JP86, JP96: DNP; FTDI_BASIC
JP9, JP17, JP27, JP37, JP47, JP57, JP67, JP77, JP87, JP97: DNP; 1X02
LED1, LED3, LED6, LED8, LED11, LED13, LED16, LED18, LED21, LED23, LED26, LED28, LED31, LED33, LED36, LED38, LED41, LED43, LED46, LED48: YELLOW; LED-0603
LED2, LED4, LED5, LED7, LED9, LED10, LED12, LED14, LED15, LED17, LED19, LED20, LED22, LED24, LED25, LED27, LED29, LED30, LED32, LED34, LED35, LED37, LED39, LED40, LED42, LED44, LED45, LED47, LED49, LED50: RED; LED-0603
Q1, Q2, Q3, Q4, Q5, Q8, Q13, Q14, Q15, Q19, Q20, Q21, Q25, Q26, Q27, Q31, Q32, Q33, Q37, Q38, Q39, Q43, Q44, Q45, Q49, Q50, Q51, Q55, Q56, Q57: MMBT2222; SOT23-3
Q6, Q9, Q10, Q11, Q16, Q17, Q22, Q23, Q28, Q29, Q34, Q35, Q40, Q41, Q46, Q47, Q52, Q53, Q58, Q59: BSS138; SOT23-3
Q7, Q12, Q18, Q24, Q30, Q36, Q42, Q48, Q54, Q60: ZXMP6A13FTA; SOT23
R1, R9, R10, R12, R18, R21, R26, R27, R28, R29, R30, R31, R33, R36, R38, R39, R42, R43, R44, R49, R50, R57, R60, R61, R71, R72, R73, R74, R77, R78, R79, R84, R85, R92, R95, R96, R106, R107, R108, R109, R112, R113, R114, R119, R120, R127, R130, R131, R141, R142, R143, R144, R147, R148, R149, R154, R155, R162, R165, R166, R176, R177, R178, R179, R182, R183, R184, R189, R190, R197, R200, R201, R211, R212, R213, R214, R217, R218, R219, R224, R225, R232, R235, R236, R246, R247, R248, R249, R252, R253, R254, R259, R260, R267, R270, R271, R281, R282, R283, R284, R287, R288, R289, R294, R295, R302, R305, R306, R316, R317, R318, R319, R322, R323, R324, R329, R330, R337, R340, R341: 10k; 0402-RES
R2, R7, R13, R32, R51, R53, R55, R70, R86, R88, R90, R105, R121, R123, R125, R140, R156, R158, R160, R175, R191, R193, R195, R210, R226, R228, R230, R245, R261, R263, R265, R280, R296, R298, R300, R315, R331, R333, R335, R350: 1k; 0402-RES
R3, R63, R98, R133, R168, R203, R238, R273, R308, R343: 62K; 0402-RES
R4, R5, R35, R37, R66, R67, R68, R69, R101, R102, R103, R104, R136, R137, R138, R139, R171, R172, R173, R174, R206, R207, R208, R209, R241, R242, R243, R244, R276, R277, R278, R279, R311, R312, R313, R314, R346, R347, R348, R349: 330; 0402-RES
R6, R64, R99, R134, R169, R204, R239, R274, R309, R344: 10K; 0402-RES
R8, R11, R52, R54, R87, R89, R122, R124, R157, R159, R192, R194, R227, R229, R262, R264, R297, R299, R332, R334: 510 0.5W; 2010
R14, R15, R58, R59, R93, R94, R128, R129, R163, R164, R198, R199, R233, R234, R268, R269, R303, R304, R338, R339: 100; 0402-RES
R16, R23, R25, R40, R56, R65, R75, R91, R100, R110, R126, R135, R145, R161, R170, R180, R196, R205, R215, R231, R240, R250, R266, R275, R285, R301, R310, R320, R336, R345: 4.7k; 0402-RES
R17, R41, R76, R111, R146, R181, R216, R251, R286, R321: 1.2k; 0402-RES
R19, R47, R82, R117, R152, R187, R222, R257, R292, R327: 866; 0402-RES
R20, R45, R80, R115, R150, R185, R220, R255, R290, R325: 240; 0402-RES
R22, R48, R83, R118, R153, R188, R223, R258, R293, R328: 374; 0402-RES
R24, R34, R46, R62, R81, R97, R116, R132, R151, R167, R186, R202, R221, R237, R256, R272, R291, R307, R326, R342: 1.5k; 0402-RES
U1, U4, U7, U10, U13, U16, U19, U22, U25, U28: 3.3V; SOT23-5
U2, U5, U8, U11, U14, U17, U20, U23, U26, U29: V_REG_317DPACK; V-REG_DPACK
U3, U6, U9, U12, U15, U18, U21, U24, U27, U30: 5V Reg.; SOT23-5
U$1, U$2, U$3, U$4, U$5, U$6, U$7, U$8, U$9, U$14: OSHW-LOGO
X1, X2, X3, X4, X5, X6, X7, X8, X9, X10: Male DB9; DB9_MALE
Y1, Y2, Y3, Y4, Y5, Y6, Y7, Y8, Y9, Y10: 16MHz; CRYSTAL-SMD-5X3

Connections:
3.3V: C1.1, C5.1, C8.1, IC1.10, IC1.25, LED1.A, LED2.A, LED3.A, LED4.A, R9.2, R18.2, R27.2, U1.5
3.3V1: C22.1, C23.1, C25.1, IC6.10, IC6.25, LED6.A, LED7.A, LED8.A, LED9.A, R42.2, R43.2, R44.2, U4.5
3.3V2: C40.1, C41.1, C43.1, IC9.10, IC9.25, LED11.A, LED12.A, LED13.A, LED14.A, R77.2, R78.2, R79.2, U7.5
3.3V3: C58.1, C59.1, C61.1, IC12.10, IC12.25, LED16.A, LED17.A, LED18.A, LED19.A, R112.2, R113.2, R114.2, U10.5
3.3V4: C76.1, C77.1, C79.1, IC15.10, IC15.25, LED21.A, LED22.A, LED23.A, LED24.A, R147.2, R148.2, R149.2, U13.5
3.3V5: C94.1, C95.1, C97.1, IC18.10, IC18.25, LED26.A, LED27.A, LED28.A, LED29.A, R182.2, R183.2, R184.2, U16.5
3.3V6: C112.1, C113.1, C115.1, IC21.10, IC21.25, LED31.A, LED32.A, LED33.A, LED34.A, R217.2, R218.2, R219.2, U19.5
3.3V7: C130.1, C131.1, C133.1, IC24.10, IC24.25, LED36.A, LED37.A, LED38.A, LED39.A, R252.2, R253.2, R254.2, U22.5
3.3V8: C148.1, C149.1, C151.1, IC27.10, IC27.25, LED41.A, LED42.A, LED43.A, LED44.A, R287.2, R288.2, R289.2, U25.5
3.3V9: C166.1, C167.1, C169.1, IC30.10, IC30.25, LED46.A, LED47.A, LED48.A, LED49.A, R322.2, R323.2, R324.2, U28.5
5V: C6.1, C11.1, C15.1, C18.A, D3.2, IC4.3, R1.2, R17.2, R25.1, R34.1, U1.1, U1.3, U3.5
5V1: C24.1, C26.1, C33.1, C36.A, D6.2, IC5.3, R41.2, R57.2, R62.1, R65.1, U4.1, U4.3, U6.5
5V2: C42.1, C44.1, C51.1, C54.A, D10.2, IC8.3, R76.2, R92.2, R97.1, R100.1, U7.1, U7.3, U9.5
5V3: C60.1, C62.1, C69.1, C72.A, D14.2, IC11.3, R111.2, R127.2, R132.1, R135.1, U10.1, U10.3, U12.5
5V4: C78.1, C80.1, C87.1, C90.A, D18.2, IC14.3, R146.2, R162.2, R167.1, R170.1, U13.1, U13.3, U15.5
5V5: C96.1, C98.1, C105.1, C108.A, D22.2, IC17.3, R181.2, R197.2, R202.1, R205.1, U16.1, U16.3, U18.5
5V6: C114.1, C116.1, C123.1, C126.A, D26.2, IC20.3, R216.2, R232.2, R237.1, R240.1, U19.1, U19.3, U21.5
5V7: C132.1, C134.1, C141.1, C144.A, D30.2, IC23.3, R251.2, R267.2, R272.1, R275.1, U22.1, U22.3, U24.5
5V8: C150.1, C152.1, C159.1, C162.A, D34.2, IC26.3, R286.2, R302.2, R307.1, R310.1, U25.1, U25.3, U27.5
5V9: C168.1, C170.1, C177.1, C180.A, D38.2, IC29.3, R321.2, R337.2, R342.1, R345.1, U28.1, U28.3, U30.5
!ISO_K_TX: IC1.22, R13.2
!ISO_K_TX1: IC6.22, R55.2
!ISO_K_TX2: IC9.22, R90.2
!ISO_K_TX3: IC12.22, R125.2
!ISO_K_TX4: IC15.22, R160.2
!ISO_K_TX5: IC18.22, R195.2
!ISO_K_TX6: IC21.22, R230.2
!ISO_K_TX7: IC24.22, R265.2
!ISO_K_TX8: IC27.22, R300.2
!ISO_K_TX9: IC30.22, R335.2
!ISO_L_TX: IC1.23, R7.2
!ISO_L_TX1: IC6.23, R53.2
!ISO_L_TX2: IC9.23, R88.2
!ISO_L_TX3: IC12.23, R123.2
!ISO_L_TX4: IC15.23, R158.2
!ISO_L_TX5: IC18.23, R193.2
!ISO_L_TX6: IC21.23, R228.2
!ISO_L_TX7: IC24.23, R263.2
!ISO_L_TX8: IC27.23, R298.2
!ISO_L_TX9: IC30.23, R333.2
!ISO_RX: IC1.8, IC3.2, R9.1
!ISO_RX1: IC2.2, IC6.8, R43.1
!ISO_RX2: IC7.2, IC9.8, R78.1
!ISO_RX3: IC10.2, IC12.8, R113.1
!ISO_RX4: IC13.2, IC15.8, R148.1
!ISO_RX5: IC16.2, IC18.8, R183.1
!ISO_RX6: IC19.2, IC21.8, R218.1
!ISO_RX7: IC22.2, IC24.8, R253.1
!ISO_RX8: IC25.2, IC27.8, R288.1
!ISO_RX9: IC28.2, IC30.8, R323.1
!OBD_RX_STATUS!/PGC: IC1.19, R4.1
!OBD_RX_STATUS!/PGC1: IC6.19, R68.1
!OBD_RX_STATUS!/PGC2: IC9.19, R103.1
!OBD_RX_STATUS!/PGC3: IC12.19, R138.1
!OBD_RX_STATUS!/PGC4: IC15.19, R173.1
!OBD_RX_STATUS!/PGC5: IC18.19, R208.1
!OBD_RX_STATUS!/PGC6: IC21.19, R243.1
!OBD_RX_STATUS!/PGC7: IC24.19, R278.1
!OBD_RX_STATUS!/PGC8: IC27.19, R313.1
!OBD_RX_STATUS!/PGC9: IC30.19, R348.1
!VPW_RX: IC1.1, IC3.14, R18.1
!VPW_RX1: IC2.14, IC6.1, R44.1
!VPW_RX2: IC7.14, IC9.1, R79.1
!VPW_RX3: IC10.14, IC12.1, R114.1
!VPW_RX4: IC13.14, IC15.1, R149.1
!VPW_RX5: IC16.14, IC18.1, R184.1
!VPW_RX6: IC19.14, IC21.1, R219.1
!VPW_RX7: IC22.14, IC24.1, R254.1
!VPW_RX8: IC25.14, IC27.1, R289.1
!VPW_RX9: IC28.14, IC30.1, R324.1
BATT_V: C7.1, IC1.27, R3.1, R6.2
BATT_V1: C30.1, IC6.27, R63.1, R64.2
BATT_V2: C48.1, IC9.27, R98.1, R99.2
BATT_V3: C66.1, IC12.27, R133.1, R134.2
BATT_V4: C84.1, IC15.27, R168.1, R169.2
BATT_V5: C102.1, IC18.27, R203.1, R204.2
BATT_V6: C120.1, IC21.27, R238.1, R239.2
BATT_V7: C138.1, IC24.27, R273.1, R274.2
BATT_V8: C156.1, IC27.27, R308.1, R309.2
BATT_V9: C174.1, IC30.27, R343.1, R344.2
CAN_HI: IC4.7, JP1.6, R14.2, X2.3
CAN_HI1: IC5.7, JP18.6, R58.2, X1.3
CAN_HI2: IC8.7, JP28.6, R93.2, X3.3
CAN_HI3: IC11.7, JP38.6, R128.2, X4.3
CAN_HI4: IC14.7, JP48.6, R163.2, X5.3
CAN_HI5: IC17.7, JP58.6, R198.2, X6.3
CAN_HI6: IC20.7, JP68.6, R233.2, X7.3
CAN_HI7: IC23.7, JP78.6, R268.2, X8.3
CAN_HI8: IC26.7, JP88.6, R303.2, X9.3
CAN_HI9: IC29.7, JP98.6, R338.2, X10.3
CAN_LO: IC4.6, JP1.7, R15.2, X2.5
CAN_LO1: IC5.6, JP18.7, R59.2, X1.5
CAN_LO2: IC8.6, JP28.7, R94.2, X3.5
CAN_LO3: IC11.6, JP38.7, R129.2, X4.5
CAN_LO4: IC14.6, JP48.7, R164.2, X5.5
CAN_LO5: IC17.6, JP58.7, R199.2, X6.5
CAN_LO6: IC20.6, JP68.7, R234.2, X7.5
CAN_LO7: IC23.6, JP78.7, R269.2, X8.5
CAN_LO8: IC26.6, JP88.7, R304.2, X9.5
CAN_LO9: IC29.6, JP98.7, R339.2, X10.5
CAN_RX: IC1.11, IC4.4
CAN_RX1: IC5.4, IC6.11
CAN_RX2: IC8.4, IC9.11
CAN_RX3: IC11.4, IC12.11
CAN_RX4: IC14.4, IC15.11
CAN_RX5: IC17.4, IC18.11
CAN_RX6: IC20.4, IC21.11
CAN_RX7: IC23.4, IC24.11
CAN_RX8: IC26.4, IC27.11
CAN_RX9: IC29.4, IC30.11
CAN_TX: IC1.12, IC4.1, R34.2
CAN_TX1: IC5.1, IC6.12, R62.2
CAN_TX2: IC8.1, IC9.12, R97.2
CAN_TX3: IC11.1, IC12.12, R132.2
CAN_TX4: IC14.1, IC15.12, R167.2
CAN_TX5: IC17.1, IC18.12, R202.2
CAN_TX6: IC20.1, IC21.12, R237.2
CAN_TX7: IC23.1, IC24.12, R272.2
CAN_TX8: IC26.1, IC27.12, R307.2
CAN_TX9: IC29.1, IC30.12, R342.2
GND: C1.2, C2.2, C3.2, C4.C, C5.2, C6.2, C7.2, C8.2, C9.C, C10.2, C11.2, C12.2, C13.2, C14.2, C15.2, C16.2, C17.2, C18.C, D2.1, IC1.5, IC1.16, IC1.24, IC1.EXP, IC3.12, IC4.2, JP1.1, JP8.GND, JP9.2, LED5.C, Q3.2, Q4.2, Q8.2, Q9.2, Q10.2, R6.1, R16.1, R22.1, R23.1, R33.2, U1.2, U3.2, X2.1, X2.2
GND1: C19.C, C20.2, C21.2, C22.2, C23.2, C24.2, C25.2, C26.2, C27.2, C28.2, C29.2, C30.2, C31.C, C32.2, C33.2, C34.2, C35.2, C36.C, D7.1, IC2.12, IC5.2, IC6.5, IC6.16, IC6.24, IC6.EXP, JP16.GND, JP17.2, JP18.1, LED10.C, Q1.2, Q2.2, Q5.2, Q6.2, Q11.2, R40.1, R48.1, R56.1, R61.2, R64.1, U4.2, U6.2, X1.1, X1.2
GND2: C37.C, C38.2, C39.2, C40.2, C41.2, C42.2, C43.2, C44.2, C45.2, C46.2, C47.2, C48.2, C49.C, C50.2, C51.2, C52.2, C53.2, C54.C, D11.1, IC7.12, IC8.2, IC9.5, IC9.16, IC9.24, IC9.EXP, JP26.GND, JP27.2, JP28.1, LED15.C, Q13.2, Q14.2, Q15.2, Q16.2, Q17.2, R75.1, R83.1, R91.1, R96.2, R99.1, U7.2, U9.2, X3.1, X3.2
GND3: C55.C, C56.2, C57.2, C58.2, C59.2, C60.2, C61.2, C62.2, C63.2, C64.2, C65.2, C66.2, C67.C, C68.2, C69.2, C70.2, C71.2, C72.C, D15.1, IC10.12, IC11.2, IC12.5, IC12.16, IC12.24, IC12.EXP, JP36.GND, JP37.2, JP38.1, LED20.C, Q19.2, Q20.2, Q21.2, Q22.2, Q23.2, R110.1, R118.1, R126.1, R131.2, R134.1, U10.2, U12.2, X4.1, X4.2
GND4: C73.C, C74.2, C75.2, C76.2, C77.2, C78.2, C79.2, C80.2, C81.2, C82.2, C83.2, C84.2, C85.C, C86.2, C87.2, C88.2, C89.2, C90.C, D19.1, IC13.12, IC14.2, IC15.5, IC15.16, IC15.24, IC15.EXP, JP46.GND, JP47.2, JP48.1, LED25.C, Q25.2, Q26.2, Q27.2, Q28.2, Q29.2, R145.1, R153.1, R161.1, R166.2, R169.1, U13.2, U15.2, X5.1, X5.2
GND5: C91.C, C92.2, C93.2, C94.2, C95.2, C96.2, C97.2, C98.2, C99.2, C100.2, C101.2, C102.2, C103.C, C104.2, C105.2, C106.2, C107.2, C108.C, D23.1, IC16.12, IC17.2, IC18.5, IC18.16, IC18.24, IC18.EXP, JP56.GND, JP57.2, JP58.1, LED30.C, Q31.2, Q32.2, Q33.2, Q34.2, Q35.2, R180.1, R188.1, R196.1, R201.2, R204.1, U16.2, U18.2, X6.1, X6.2
GND6: C109.C, C110.2, C111.2, C112.2, C113.2, C114.2, C115.2, C116.2, C117.2, C118.2, C119.2, C120.2, C121.C, C122.2, C123.2, C124.2, C125.2, C126.C, D27.1, IC19.12, IC20.2, IC21.5, IC21.16, IC21.24, IC21.EXP, JP66.GND, JP67.2, JP68.1, LED35.C, Q37.2, Q38.2, Q39.2, Q40.2, Q41.2, R215.1, R223.1, R231.1, R236.2, R239.1, U19.2, U21.2, X7.1, X7.2
GND7: C127.C, C128.2, C129.2, C130.2, C131.2, C132.2, C133.2, C134.2, C135.2, C136.2, C137.2, C138.2, C139.C, C140.2, C141.2, C142.2, C143.2, C144.C, D31.1, IC22.12, IC23.2, IC24.5, IC24.16, IC24.24, IC24.EXP, JP76.GND, JP77.2, JP78.1, LED40.C, Q43.2, Q44.2, Q45.2, Q46.2, Q47.2, R250.1, R258.1, R266.1, R271.2, R274.1, U22.2, U24.2, X8.1, X8.2
GND8: C145.C, C146.2, C147.2, C148.2, C149.2, C150.2, C151.2, C152.2, C153.2, C154.2, C155.2, C156.2, C157.C, C158.2, C159.2, C160.2, C161.2, C162.C, D35.1, IC25.12, IC26.2, IC27.5, IC27.16, IC27.24, IC27.EXP, JP86.GND, JP87.2, JP88.1, LED45.C, Q49.2, Q50.2, Q51.2, Q52.2, Q53.2, R285.1, R293.1, R301.1, R306.2, R309.1, U25.2, U27.2, X9.1, X9.2
GND9: C163.C, C164.2, C165.2, C166.2, C167.2, C168.2, C169.2, C170.2, C171.2, C172.2, C173.2, C174.2, C175.C, C176.2, C177.2, C178.2, C179.2, C180.C, D39.1, IC28.12, IC29.2, IC30.5, IC30.16, IC30.24, IC30.EXP, JP96.GND, JP97.2, JP98.1, LED50.C, Q55.2, Q56.2, Q57.2, Q58.2, Q59.2, R320.1, R328.1, R336.1, R341.2, R344.1, U28.2, U30.2, X10.1, X10.2
J1850BUS+: D1.1, JP1.3, R21.1, R28.1, R30.1, X2.7
J1850BUS+1: D5.1, JP18.3, R26.1, R39.1, R50.1, X1.7
J1850BUS+2: D9.1, JP28.3, R71.1, R74.1, R85.1, X3.7
J1850BUS+3: D13.1, JP38.3, R106.1, R109.1, R120.1, X4.7
J1850BUS+4: D17.1, JP48.3, R141.1, R144.1, R155.1, X5.7
J1850BUS+5: D21.1, JP58.3, R176.1, R179.1, R190.1, X6.7
J1850BUS+6: D25.1, JP68.3, R211.1, R214.1, R225.1, X7.7
J1850BUS+7: D29.1, JP78.3, R246.1, R249.1, R260.1, X8.7
J1850BUS+8: D33.1, JP88.3, R281.1, R284.1, R295.1, X9.7
J1850BUS+9: D37.1, JP98.3, R316.1, R319.1, R330.1, X10.7
J1850BUS+_TX: IC1.3, Q9.1
J1850BUS+_TX1: IC6.3, Q6.1
J1850BUS+_TX2: IC9.3, Q16.1
J1850BUS+_TX3: IC12.3, Q22.1
J1850BUS+_TX4: IC15.3, Q28.1
J1850BUS+_TX5: IC18.3, Q34.1
J1850BUS+_TX6: IC21.3, Q40.1
J1850BUS+_TX7: IC24.3, Q46.1
J1850BUS+_TX8: IC27.3, Q52.1
J1850BUS+_TX9: IC30.3, Q58.1
J1850BUS-: JP1.2, Q8.3, R29.1, R31.2, X2.6
J1850BUS-1: JP18.2, Q5.3, R36.1, R49.2, X1.6
J1850BUS-2: JP28.2, Q15.3, R72.1, R84.2, X3.6
J1850BUS-3: JP38.2, Q21.3, R107.1, R119.2, X4.6
J1850BUS-4: JP48.2, Q27.3, R142.1, R154.2, X5.6
J1850BUS-5: JP58.2, Q33.3, R177.1, R189.2, X6.6
J1850BUS-6: JP68.2, Q39.3, R212.1, R224.2, X7.6
J1850BUS-7: JP78.2, Q45.3, R247.1, R259.2, X8.6
J1850BUS-8: JP88.2, Q51.3, R282.1, R294.2, X9.6
J1850BUS-9: JP98.2, Q57.3, R317.1, R329.2, X10.6
J1850BUS-_TX: IC1.4, R32.1
J1850BUS-_TX1: IC6.4, R51.1
J1850BUS-_TX2: IC9.4, R86.1
J1850BUS-_TX3: IC12.4, R121.1
J1850BUS-_TX4: IC15.4, R156.1
J1850BUS-_TX5: IC18.4, R191.1
J1850BUS-_TX6: IC21.4, R226.1
J1850BUS-_TX7: IC24.4, R261.1
J1850BUS-_TX8: IC27.4, R296.1
J1850BUS-_TX9: IC30.4, R331.1
K-LINE: JP1.5, Q4.3, R11.2, R12.1, X2.4
K-LINE1: JP18.5, Q2.3, R38.1, R54.2, X1.4
K-LINE2: JP28.5, Q14.3, R73.1, R89.2, X3.4
K-LINE3: JP38.5, Q20.3, R108.1, R124.2, X4.4
K-LINE4: JP48.5, Q26.3, R143.1, R159.2, X5.4
K-LINE5: JP58.5, Q32.3, R178.1, R194.2, X6.4
K-LINE6: JP68.5, Q38.3, R213.1, R229.2, X7.4
K-LINE7: JP78.5, Q44.3, R248.1, R264.2, X8.4
K-LINE8: JP88.5, Q50.3, R283.1, R299.2, X9.4
K-LINE9: JP98.5, Q56.3, R318.1, R334.2, X10.4
L-LINE: JP1.4, Q3.3, R8.2, X2.8
L-LINE1: JP18.4, Q1.3, R52.2, X1.8
L-LINE2: JP28.4, Q13.3, R87.2, X3.8
L-LINE3: JP38.4, Q19.3, R122.2, X4.8
L-LINE4: JP48.4, Q25.3, R157.2, X5.8
L-LINE5: JP58.4, Q31.3, R192.2, X6.8
L-LINE6: JP68.4, Q37.3, R227.2, X7.8
L-LINE7: JP78.4, Q43.3, R262.2, X8.8
L-LINE8: JP88.4, Q49.3, R297.2, X9.8
L-LINE9: JP98.4, Q55.3, R332.2, X10.8
unnamed: IC3.7, R28.2
unnamed: C19.A, IC6.17
unnamed: IC3.6, R29.2
unnamed: Q4.1, R13.1
unnamed: Q3.1, R7.1
unnamed: IC3.5, R10.2, R33.1
unnamed: IC3.8, R21.2
unnamed: R19.2, R20.2, U2.1
unnamed: D1.2, Q7.3
unnamed: C12.1, R14.1
unnamed: IC4.8, R16.2
unnamed: IC3.9, R17.1, R23.2
unnamed: IC3.4, R12.2
unnamed: D3.1, R31.1
unnamed: IC2.7, R26.2
unnamed: IC2.6, R36.2
unnamed: IC2.9, R40.2, R41.1
unnamed: Q7.1, Q9.3, R24.2
unnamed: D6.1, R49.1
unnamed: Q6.3, Q12.1, R46.2
unnamed: Q11.3, R47.1, R48.2
unnamed: Q10.3, R19.1, R22.2
unnamed: D7.2, R50.2
unnamed: D2.2, R30.2
unnamed: Q8.1, R32.2
unnamed: C4.A, IC1.17
unnamed: C13.1, R15.1
unnamed: Q5.1, R51.2
unnamed: Q2.1, R55.1
unnamed: LED3.C, R4.2
unnamed: LED4.C, R5.1
unnamed: LED5.A, R2.1
unnamed: Q1.1, R53.1
unnamed: C16.1, U3.4
unnamed: LED1.C, R35.2
unnamed: LED2.C, R37.1
unnamed: IC5.8, R56.2
unnamed: C27.1, R58.1
unnamed: C28.1, R59.1
unnamed: R45.2, R47.2, U5.1
unnamed: IC2.5, R60.2, R61.1
unnamed: IC2.4, R38.2
unnamed: IC2.8, R39.2
unnamed: D5.2, Q12.3
unnamed: LED6.C, R66.2
unnamed: LED7.C, R67.1
unnamed: LED8.C, R68.2
unnamed: LED9.C, R69.1
unnamed: C34.1, U6.4
unnamed: LED10.A, R70.1
unnamed: C37.A, IC9.17
unnamed: IC7.7, R71.2
unnamed: IC7.6, R72.2
unnamed: IC7.9, R75.2, R76.1
unnamed: D10.1, R84.1
unnamed: Q16.3, Q18.1, R81.2
unnamed: Q17.3, R82.1, R83.2
unnamed: D11.2, R85.2
unnamed: Q15.1, R86.2
unnamed: Q14.1, R90.1
unnamed: Q13.1, R88.1
unnamed: IC8.8, R91.2
unnamed: C45.1, R93.1
unnamed: C46.1, R94.1
unnamed: R80.2, R82.2, U8.1
unnamed: IC7.5, R95.2, R96.1
unnamed: IC7.4, R73.2
unnamed: IC7.8, R74.2
unnamed: D9.2, Q18.3
unnamed: LED11.C, R101.2
unnamed: LED12.C, R102.1
unnamed: LED13.C, R103.2
unnamed: LED14.C, R104.1
unnamed: C52.1, U9.4
unnamed: LED15.A, R105.1
unnamed: C55.A, IC12.17
unnamed: IC10.7, R106.2
unnamed: IC10.6, R107.2
unnamed: IC10.9, R110.2, R111.1
unnamed: D14.1, R119.1
unnamed: Q22.3, Q24.1, R116.2
unnamed: Q23.3, R117.1, R118.2
unnamed: D15.2, R120.2
unnamed: Q21.1, R121.2
unnamed: Q20.1, R125.1
unnamed: Q19.1, R123.1
unnamed: IC11.8, R126.2
unnamed: C63.1, R128.1
unnamed: C64.1, R129.1
unnamed: R115.2, R117.2, U11.1
unnamed: IC10.5, R130.2, R131.1
unnamed: IC10.4, R108.2
unnamed: IC10.8, R109.2
unnamed: D13.2, Q24.3
unnamed: LED16.C, R136.2
unnamed: LED17.C, R137.1
unnamed: LED18.C, R138.2
unnamed: LED19.C, R139.1
unnamed: C70.1, U12.4
unnamed: LED20.A, R140.1
unnamed: C73.A, IC15.17
unnamed: IC13.7, R141.2
unnamed: IC13.6, R142.2
unnamed: IC13.9, R145.2, R146.1
unnamed: D18.1, R154.1
unnamed: Q28.3, Q30.1, R151.2
unnamed: Q29.3, R152.1, R153.2
unnamed: D19.2, R155.2
unnamed: Q27.1, R156.2
unnamed: Q26.1, R160.1
unnamed: Q25.1, R158.1
unnamed: IC14.8, R161.2
unnamed: C81.1, R163.1
unnamed: C82.1, R164.1
unnamed: R150.2, R152.2, U14.1
unnamed: IC13.5, R165.2, R166.1
unnamed: IC13.4, R143.2
unnamed: IC13.8, R144.2
unnamed: D17.2, Q30.3
unnamed: LED21.C, R171.2
unnamed: LED22.C, R172.1
unnamed: LED23.C, R173.2
unnamed: LED24.C, R174.1
unnamed: C88.1, U15.4
unnamed: LED25.A, R175.1
unnamed: C91.A, IC18.17
unnamed: IC16.7, R176.2
unnamed: IC16.6, R177.2
unnamed: IC16.9, R180.2, R181.1
unnamed: D22.1, R189.1
unnamed: Q34.3, Q36.1, R186.2
unnamed: Q35.3, R187.1, R188.2
unnamed: D23.2, R190.2
unnamed: Q33.1, R191.2
unnamed: Q32.1, R195.1
unnamed: Q31.1, R193.1
unnamed: IC17.8, R196.2
unnamed: C99.1, R198.1
unnamed: C100.1, R199.1
unnamed: R185.2, R187.2, U17.1
unnamed: IC16.5, R200.2, R201.1
unnamed: IC16.4, R178.2
unnamed: IC16.8, R179.2
unnamed: D21.2, Q36.3
unnamed: LED26.C, R206.2
unnamed: LED27.C, R207.1
unnamed: LED28.C, R208.2
unnamed: LED29.C, R209.1
unnamed: C106.1, U18.4
unnamed: LED30.A, R210.1
unnamed: C109.A, IC21.17
unnamed: IC19.7, R211.2
unnamed: IC19.6, R212.2
unnamed: IC19.9, R215.2, R216.1
unnamed: D26.1, R224.1
unnamed: Q40.3, Q42.1, R221.2
unnamed: Q41.3, R222.1, R223.2
unnamed: D27.2, R225.2
unnamed: Q39.1, R226.2
unnamed: Q38.1, R230.1
unnamed: Q37.1, R228.1
unnamed: IC20.8, R231.2
unnamed: C117.1, R233.1
unnamed: C118.1, R234.1
unnamed: R220.2, R222.2, U20.1
unnamed: IC19.5, R235.2, R236.1
unnamed: IC19.4, R213.2
unnamed: IC19.8, R214.2
unnamed: D25.2, Q42.3
unnamed: LED31.C, R241.2
unnamed: LED32.C, R242.1
unnamed: LED33.C, R243.2
unnamed: LED34.C, R244.1
unnamed: C124.1, U21.4
unnamed: LED35.A, R245.1
unnamed: C127.A, IC24.17
unnamed: IC22.7, R246.2
unnamed: IC22.6, R247.2
unnamed: IC22.9, R250.2, R251.1
unnamed: D30.1, R259.1
unnamed: Q46.3, Q48.1, R256.2
unnamed: Q47.3, R257.1, R258.2
unnamed: D31.2, R260.2
unnamed: Q45.1, R261.2
unnamed: Q44.1, R265.1
unnamed: Q43.1, R263.1
unnamed: IC23.8, R266.2
unnamed: C135.1, R268.1
unnamed: C136.1, R269.1
unnamed: R255.2, R257.2, U23.1
unnamed: IC22.5, R270.2, R271.1
unnamed: IC22.4, R248.2
unnamed: IC22.8, R249.2
unnamed: D29.2, Q48.3
unnamed: LED36.C, R276.2
unnamed: LED37.C, R277.1
unnamed: LED38.C, R278.2
unnamed: LED39.C, R279.1
unnamed: C142.1, U24.4
unnamed: LED40.A, R280.1
unnamed: C145.A, IC27.17
unnamed: IC25.7, R281.2
unnamed: IC25.6, R282.2
unnamed: IC25.9, R285.2, R286.1
unnamed: D34.1, R294.1
unnamed: Q52.3, Q54.1, R291.2
unnamed: Q53.3, R292.1, R293.2
unnamed: D35.2, R295.2
unnamed: Q51.1, R296.2
unnamed: Q50.1, R300.1
unnamed: Q49.1, R298.1
unnamed: IC26.8, R301.2
unnamed: C153.1, R303.1
unnamed: C154.1, R304.1
unnamed: R290.2, R292.2, U26.1
unnamed: IC25.5, R305.2, R306.1
unnamed: IC25.4, R283.2
unnamed: IC25.8, R284.2
unnamed: D33.2, Q54.3
unnamed: LED41.C, R311.2
unnamed: LED42.C, R312.1
unnamed: LED43.C, R313.2
unnamed: LED44.C, R314.1
unnamed: C160.1, U27.4
unnamed: LED45.A, R315.1
unnamed: C163.A, IC30.17
unnamed: IC28.7, R316.2
unnamed: IC28.6, R317.2
unnamed: IC28.9, R320.2, R321.1
unnamed: D38.1, R329.1
unnamed: Q58.3, Q60.1, R326.2
unnamed: Q59.3, R327.1, R328.2
unnamed: D39.2, R330.2
unnamed: Q57.1, R331.2
unnamed: Q56.1, R335.1
unnamed: Q55.1, R333.1
unnamed: IC29.8, R336.2
unnamed: C171.1, R338.1
unnamed: C172.1, R339.1
unnamed: R325.2, R327.2, U29.1
unnamed: IC28.5, R340.2, R341.1
unnamed: IC28.4, R318.2
unnamed: IC28.8, R319.2
unnamed: D37.2, Q60.3
unnamed: LED46.C, R346.2
unnamed: LED47.C, R347.1
unnamed: LED48.C, R348.2
unnamed: LED49.C, R349.1
unnamed: C178.1, U30.4
unnamed: LED50.A, R350.1
OSC1: C2.1, IC1.6, Y1.3
OSC2: C3.1, IC1.7, Y1.1
OSC3: C20.1, IC6.6, Y2.3
OSC4: C21.1, IC6.7, Y2.1
OSC5: C38.1, IC9.6, Y3.3
OSC6: C39.1, IC9.7, Y3.1
OSC7: C56.1, IC12.6, Y4.3
OSC8: C57.1, IC12.7, Y4.1
OSC9: C74.1, IC15.6, Y5.3
OSC10: C75.1, IC15.7, Y5.1
OSC11: C92.1, IC18.6, Y6.3
OSC12: C93.1, IC18.7, Y6.1
OSC13: C110.1, IC21.6, Y7.3
OSC14: C111.1, IC21.7, Y7.1
OSC15: C128.1, IC24.6, Y8.3
OSC16: C129.1, IC24.7, Y8.1
OSC17: C146.1, IC27.6, Y9.3
OSC18: C147.1, IC27.7, Y9.1
OSC19: C164.1, IC30.6, Y10.3
OSC20: C165.1, IC30.7, Y10.1
PWM/!VPW: IC1.28, Q10.1
PWM/!VPW1: IC6.28, Q11.1
PWM/!VPW2: IC9.28, Q17.1
PWM/!VPW3: IC12.28, Q23.1
PWM/!VPW4: IC15.28, Q29.1
PWM/!VPW5: IC18.28, Q35.1
PWM/!VPW6: IC21.28, Q41.1
PWM/!VPW7: IC24.28, Q47.1
PWM/!VPW8: IC27.28, Q53.1
PWM/!VPW9: IC30.28, Q59.1
PWM_RX: IC1.2, IC3.1, R27.1
PWM_RX1: IC2.1, IC6.2, R42.1
PWM_RX2: IC7.1, IC9.2, R77.1
PWM_RX3: IC10.1, IC12.2, R112.1
PWM_RX4: IC13.1, IC15.2, R147.1
PWM_RX5: IC16.1, IC18.2, R182.1
PWM_RX6: IC19.1, IC21.2, R217.1
PWM_RX7: IC22.1, IC24.2, R252.1
PWM_RX8: IC25.1, IC27.2, R287.1
PWM_RX9: IC28.1, IC30.2, R322.1
RESET: IC1.26, R1.1
RESET1: IC6.26, R57.1
RESET2: IC9.26, R92.1
RESET3: IC12.26, R127.1
RESET4: IC15.26, R162.1
RESET5: IC18.26, R197.1
RESET6: IC21.26, R232.1
RESET7: IC24.26, R267.1
RESET8: IC27.26, R302.1
RESET9: IC30.26, R337.1
RST_NVM: IC1.18, JP9.1, R5.2
RST_NVM1: IC6.18, JP17.1, R69.2
RST_NVM2: IC9.18, JP27.1, R104.2
RST_NVM3: IC12.18, JP37.1, R139.2
RST_NVM4: IC15.18, JP47.1, R174.2
RST_NVM5: IC18.18, JP57.1, R209.2
RST_NVM6: IC21.18, JP67.1, R244.2
RST_NVM7: IC24.18, JP77.1, R279.2
RST_NVM8: IC27.18, JP87.1, R314.2
RST_NVM9: IC30.18, JP97.1, R349.2
RX-I: IC1.13, JP8.TXO
RX-I1: IC6.13, JP16.TXO
RX-I2: IC9.13, JP26.TXO
RX-I3: IC12.13, JP36.TXO
RX-I4: IC15.13, JP46.TXO
RX-I5: IC18.13, JP56.TXO
RX-I6: IC21.13, JP66.TXO
RX-I7: IC24.13, JP76.TXO
RX-I8: IC27.13, JP86.TXO
RX-I9: IC30.13, JP96.TXO
RX-STAT: IC1.21, R35.1
RX-STAT1: IC6.21, R66.1
RX-STAT2: IC9.21, R101.1
RX-STAT3: IC12.21, R136.1
RX-STAT4: IC15.21, R171.1
RX-STAT5: IC18.21, R206.1
RX-STAT6: IC21.21, R241.1
RX-STAT7: IC24.21, R276.1
RX-STAT8: IC27.21, R311.1
RX-STAT9: IC30.21, R346.1
TX-O: IC1.14, JP8.RXI, R25.2
TX-O1: IC6.14, JP16.RXI, R65.2
TX-O2: IC9.14, JP26.RXI, R100.2
TX-O3: IC12.14, JP36.RXI, R135.2
TX-O4: IC15.14, JP46.RXI, R170.2
TX-O5: IC18.14, JP56.RXI, R205.2
TX-O6: IC21.14, JP66.RXI, R240.2
TX-O7: IC24.14, JP76.RXI, R275.2
TX-O8: IC27.14, JP86.RXI, R310.2
TX-O9: IC30.14, JP96.RXI, R345.2
TX-STAT: IC1.20, R37.2
TX-STAT1: IC6.20, R67.2
TX-STAT2: IC9.20, R102.2
TX-STAT3: IC12.20, R137.2
TX-STAT4: IC15.20, R172.2
TX-STAT5: IC18.20, R207.2
TX-STAT6: IC21.20, R242.2
TX-STAT7: IC24.20, R277.2
TX-STAT8: IC27.20, R312.2
TX-STAT9: IC30.20, R347.2
VBAT: C14.1, D4.C, IC3.3, JP1.8, R8.1, R10.1, R11.1, U2.3
VBAT1: C29.1, D8.C, IC2.3, JP18.8, R52.1, R54.1, R60.1, U5.3
VBAT2: C47.1, D12.C, IC7.3, JP28.8, R87.1, R89.1, R95.1, U8.3
VBAT3: C65.1, D16.C, IC10.3, JP38.8, R122.1, R124.1, R130.1, U11.3
VBAT4: C83.1, D20.C, IC13.3, JP48.8, R157.1, R159.1, R165.1, U14.3
VBAT5: C101.1, D24.C, IC16.3, JP58.8, R192.1, R194.1, R200.1, U17.3
VBAT6: C119.1, D28.C, IC19.3, JP68.8, R227.1, R229.1, R235.1, U20.3
VBAT7: C137.1, D32.C, IC22.3, JP78.8, R262.1, R264.1, R270.1, U23.3
VBAT8: C155.1, D36.C, IC25.3, JP88.8, R297.1, R299.1, R305.1, U26.3
VBAT9: C173.1, D40.C, IC28.3, JP98.8, R332.1, R334.1, R340.1, U29.3
VBATT_RAW: D4.A, R3.2, X2.9
VBATT_RAW1: D8.A, R63.2, X1.9
VBATT_RAW2: D12.A, R98.2, X3.9
VBATT_RAW3: D16.A, R133.2, X4.9
VBATT_RAW4: D20.A, R168.2, X5.9
VBATT_RAW5: D24.A, R203.2, X6.9
VBATT_RAW6: D28.A, R238.2, X7.9
VBATT_RAW7: D32.A, R273.2, X8.9
VBATT_RAW8: D36.A, R308.2, X9.9
VBATT_RAW9: D40.A, R343.2, X10.9
VCC: C9.A, C10.1, C17.1, Q7.2, R2.2, R20.1, R24.1, U2.4, U3.1, U3.3
VCC1: C31.A, C32.1, C35.1, Q12.2, R45.1, R46.1, R70.2, U5.4, U6.1, U6.3
VCC2: C49.A, C50.1, C53.1, Q18.2, R80.1, R81.1, R105.2, U8.4, U9.1, U9.3
VCC3: C67.A, C68.1, C71.1, Q24.2, R115.1, R116.1, R140.2, U11.4, U12.1, U12.3
VCC4: C85.A, C86.1, C89.1, Q30.2, R150.1, R151.1, R175.2, U14.4, U15.1, U15.3
VCC5: C103.A, C104.1, C107.1, Q36.2, R185.1, R186.1, R210.2, U17.4, U18.1, U18.3
VCC6: C121.A, C122.1, C125.1, Q42.2, R220.1, R221.1, R245.2, U20.4, U21.1, U21.3
VCC7: C139.A, C140.1, C143.1, Q48.2, R255.1, R256.1, R280.2, U23.4, U24.1, U24.3
VCC8: C157.A, C158.1, C161.1, Q54.2, R290.1, R291.1, R315.2, U26.4, U27.1, U27.3
VCC9: C175.A, C176.1, C179.1, Q60.2, R325.1, R326.1, R350.2, U29.4, U30.1, U30.3
