farezhalim/vehicle-immobilizing-device/testing/hardware/testing.sch

## EAGLE design testing/hardware/testing.sch (2019-04-12)

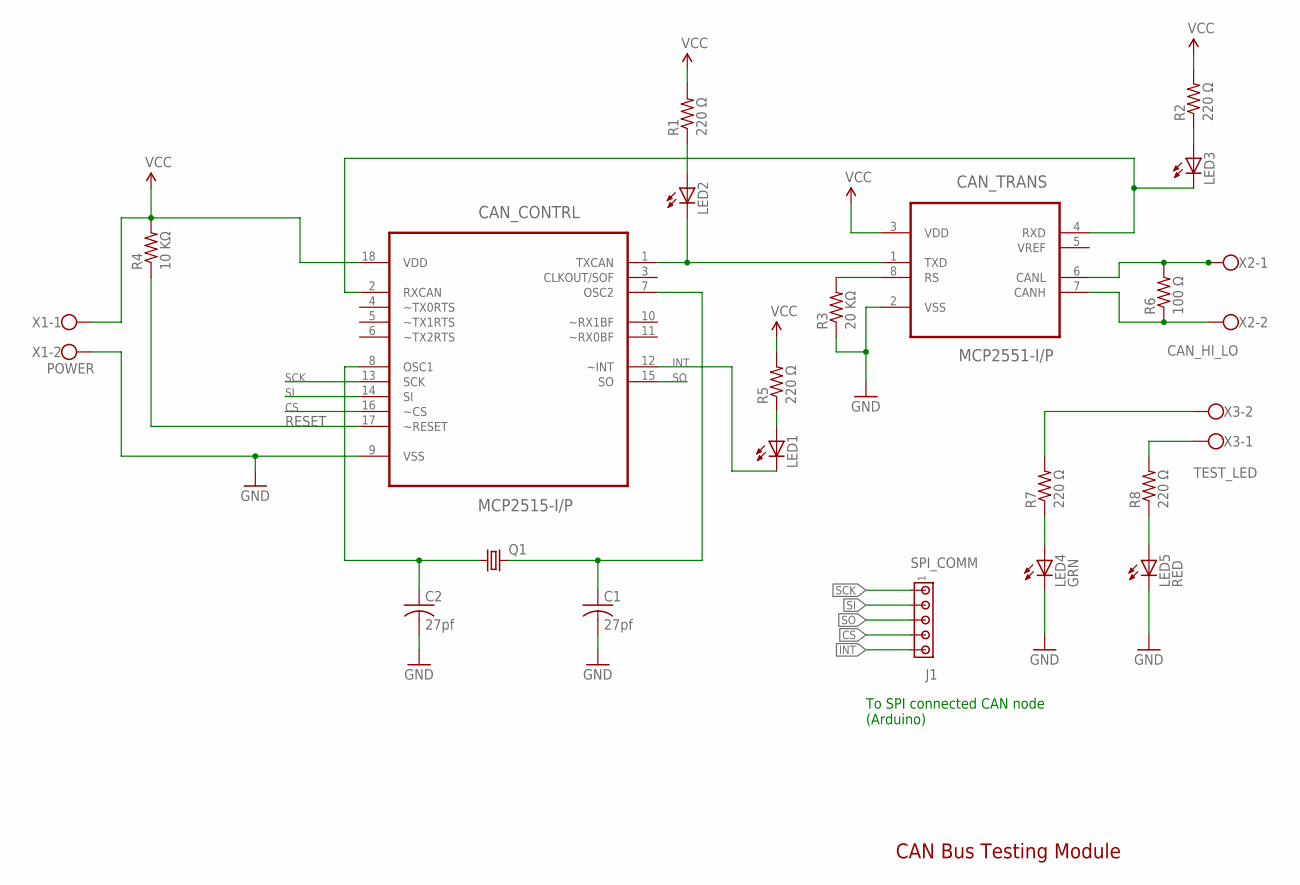
[picture p41: schematic testing.sch]

Parts:
C1, C2: 27pf; C025-040X050
CAN_CONTRL: MCP2515-I/P; DIP254P762X432-18
CAN_TRANS: MCP2551-I/P; DIP254P762X432-8
J1: SPI_COMM; 1X5MTA
LED1, LED2, LED3: LED5MM
LED4: GRN; LED5MM
LED5: RED; LED5MM
Q1: CRYTALHC18U-V; HC18U-V
R1, R2, R5, R7, R8: 220 Ω; 0204/7
R3: 20 KΩ; 0204/7
R4: 10 KΩ; 0204/7
R6: 100 Ω; 0204/7
X1: POWER; W237-102
X2: CAN_HI_LO; W237-102
X3: TEST_LED; W237-102

Connections:
CAN_H: CAN_TRANS.7 (CANH), R6.1, X2.2
CAN_L: CAN_TRANS.6 (CANL), R6.2, X2.1
CS: CAN_CONTRL.16 (~CS), J1.4
GND: C1.2, C2.2, CAN_CONTRL.9 (VSS), CAN_TRANS.2 (VSS), LED4.K (C), LED5.K (C), R3.1, X1.2
INT: CAN_CONTRL.12 (~INT), J1.5, LED1.K (C)
unnamed: R7.2, X3.2
unnamed: R8.2, X3.1
unnamed: C2.1, CAN_CONTRL.8 (OSC1), Q1.1
unnamed: C1.1, CAN_CONTRL.7 (OSC2), Q1.2
unnamed: LED1.A, R5.1
unnamed: LED2.A, R1.1
unnamed: LED4.A, R7.1
unnamed: LED3.A, R2.1
unnamed: LED5.A, R8.1
unnamed: CAN_TRANS.8 (RS), R3.2
RESET: CAN_CONTRL.17 (~RESET), R4.1
RXCAN: CAN_CONTRL.2 (RXCAN), CAN_TRANS.4 (RXD), LED3.K (C)
SCK: CAN_CONTRL.13 (SCK), J1.1
SI: CAN_CONTRL.14 (SI), J1.2
SO: CAN_CONTRL.15 (SO), J1.3
TXCAN: CAN_CONTRL.1 (TXCAN), CAN_TRANS.1 (TXD), LED2.K (C)
VCC: CAN_CONTRL.18 (VDD), CAN_TRANS.3 (VDD), R1.2, R2.2, R4.2, R5.2, X1.1

Notes on the sheet:
CAN Bus Testing Module
To SPI connected CAN node (Arduino)
