farezhalim/vehicle-immobilizing-device/(commit log)

2019-01-30 Sign in & register buttons connected to Firebase and functional
2019-02-05 Update hardware/.gitkeep Deleted raspberry_pi/.gitkeep, accelerometer/.gitkeep files
2019-02-05 adding eagle files
    [schematic.sch]
2019-02-05 Adding manufacturer schematics
    [Adafruit_ADXL345.brd, Adafruit_ADXL345.sch, OBD-II-UART.brd, OBD-II-UART.sch, OBD-II-UART_Panel_v13.brd]
2019-02-05 accelerometer data logger simple program
2019-02-05 prototype schematic
    [schematic.sch]
2019-02-07 schematic completed
    [schematic.brd, schematic.sch]
2019-02-07 changed a connector
    [schematic.sch]
2019-02-07 added can bus shield libraries
2019-02-09 routed signals
    [OBD-II-UART.brd, schematic.brd, schematic.sch]
2019-02-09 Bluetooth Conf File for password
    [bluetooth.cfg]
2019-02-10 added status LEDs to main board, completed board for CAN test module
    [schematic.brd, schematic.sch, testing.sch]
2019-02-18 CAM files for PCB
    [schematic.brd, schematic.sch, testing.sch]
2019-02-20 fixed sign in button
2019-02-22 all arduino / tester code
    [schematic.brd, schematic.sch]
2019-03-09 test module updates
    [schematic.brd, testing.sch]
2019-03-19 raspberry pi code
2019-03-20 android app plus updated board
    [OBD-II-UART.brd, schematic.brd, schematic.sch, testing.sch]
2019-03-22 future design schematic and layout
    [schematic.sch, testing.sch]
2019-03-30 all software working on raspberry pi 3b
    [bluetooth.cfg, testing.sch]
2019-04-06 App aesthetic fixes + future board layout
    [schematic.sch]
2019-04-07 Bluetooth discover list filters out devices without a name
2019-04-12 minor schematic tweaks
    [schematic.sch, testing.sch]
2019-04-12 All raspberry pi code
2019-04-12 some housekeeping items
    [back_alley_drive.csv, drive_2.csv, drive_3.csv, drive_4.csv, hardbrake_1.csv, hardbrake_2.csv, hardbrake_3.csv, hardbrake_4.csv]
2019-04-12 added credits in schematic
    [schematic.sch]
2019-04-12 updated some comments
    [bluetooth.cfg]
2019-04-12 Add accelerometer readme
